JesseLevine727/AirNote/hardware/outputs/airnote-board.png

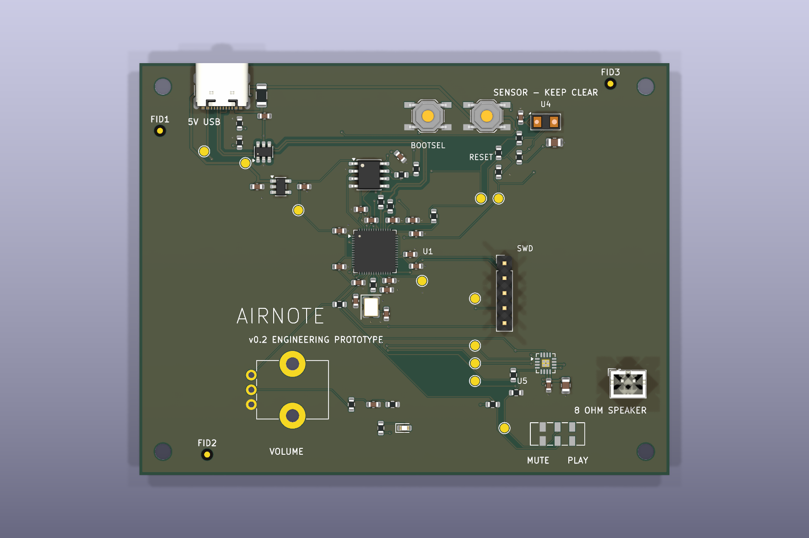
hardware/outputs/airnote-board.png
