JesseLevine727/AirNote/hardware/outputs/airnote-placement.png

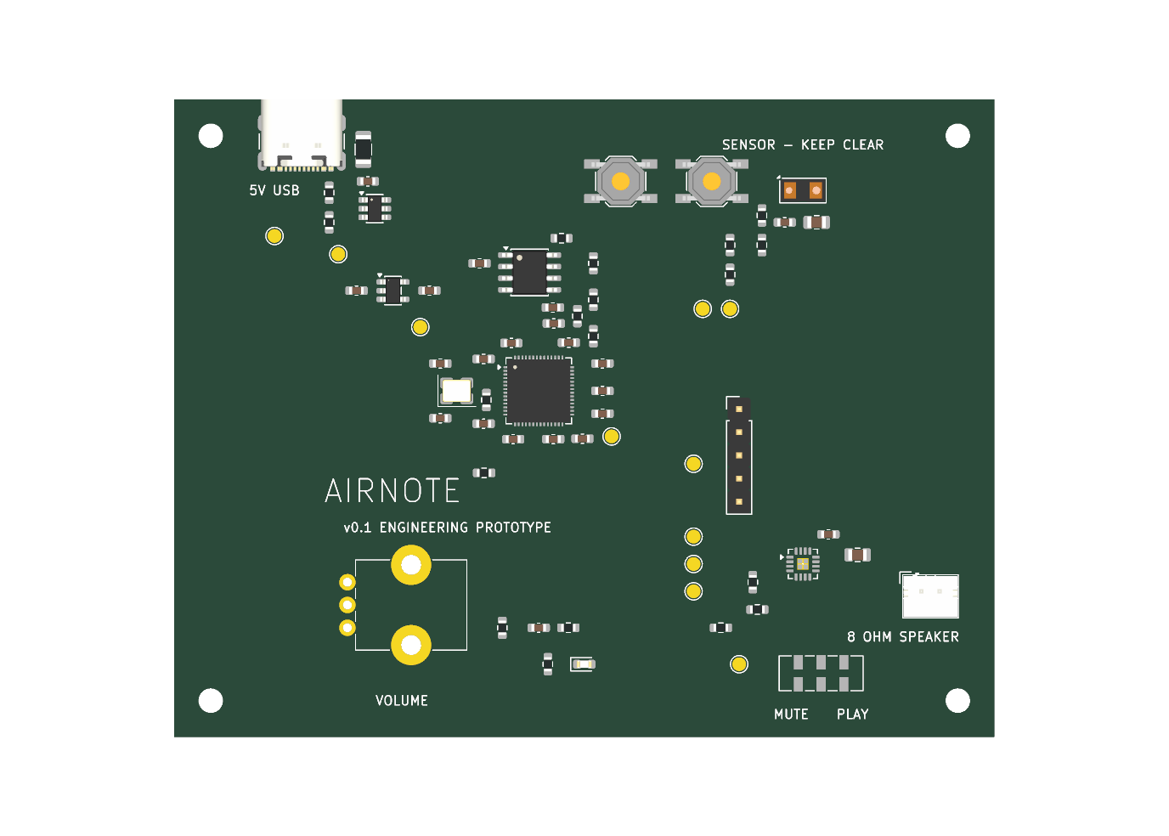
hardware/outputs/airnote-placement.png
