JesseLevine727/AirNote/hardware/reference/RPI-RP2040-MINIMAL_R3-S1_public/RPI-RP2040-MINIMAL_R3-S1_BOM.xlsx

Sheet: TOP
DOCUMENT IS AUTO-GENERATED, DO NOT HAND MODIFY
Variant Name | RPI-RP2040-MINIMAL | <-- Name of specific variant this BOM is for
Variant Description | RP2040 Minimal Design Example
PCB Revision | R3 | <-- PCB revision this BOM is for
Schematic/BOM Revision | S1 | <-- Schematic/BOM revision
Generation Date | 2026-07-08 13:39:50 UTC
Generation Format | 11

Sheet: BOM
Item | QTY | Refs | Value | Manufacturer | Manufacturer-PN | RPI-PDB-PN | Description
1 | 3 | C1,C4,C17 | 10u | Murata | GRM21BR61C106KE15L | RP-01GYSK-AVBE41 | Capacitor, MLCC, 10uF, 10%, M2012, 16V, X5R
2 | 2 | C2,C3 | 15p | Murata | GRM1555C1H150JA01D | RP-01C89W-LLY9XV | Capacitor, MLCC, 15pF, 5%, M1005, 50V, C0G
3 | 10 | C5,C6,C7,C9,C11,C12,C13,C14,C15,C16 | 100n | Murata | GRM155R71E104KE14D | RP-01BJ9Y-KRGF41 | Capacitor, MLCC, 100nF, 10%, M1005, 25V, X7R (10k Reel)
4 | 2 | C8,C10 | 1u | Murata | GRM155R61C105KA12D | RP-01GYSK-L7FEKV | Capacitor, MLCC, 1uF, 10%, M1005, 16V, X5R (10k Reel)
5 | 1 | J1 | 10103594-0001LF | Amphenol | 10103594-0001LF | RP-019A1P-1JAX7V | Micro-USB B, Socket, RA, PTH/SMT
6 | 1 | J2 | TSW-102-07-G-S | Samtec | TSW-102-07-G-S | RP-01JV5X-LY21H5 | Pin Header, 01x02W, 2.54mm, PTH, Male
7 | 2 | J3,J4 | TSW-118-07-L-D | Samtec | TSW-118-07-L-D | RP-01JWH2-G371Y4 | Pin Header, 02x18W, 2.54mm, PTH, Male
8 | 2 | R1,R5 | 1k | Yageo | RC0402FR-071KL | RP-019A1P-4Z6ZWY | Resistor, Chip, 1kR, M1005, 63mW, 1% (10k Reel)
9 | 1 | R2 | NO-FIT |  | NO-FIT
10 | 2 | R3,R4 | 27 | Yageo | RC0402FR-0727RL | RP-01C89V-LTEYC4 | Resistor, Chip, 27R, M1005, 63mW, 1% (10k Reel)
11 | 1 | U1 | NCP1117ST33T3G | ON Semiconductor | NCP1117ST33T3G | RP-01JWD9-7JRX6J | LDO, Vin=4.75-20V, Vout=3.3V, 1A min, SOT-223
12 | 1 | U2 | W25Q128JVSIQ | Winbond | W25Q128JVSIQ | RP-01JWD4-F1H4N9 | Serial NOR Flash, QSPI, 3V, 128Mbit, SOIC-8
13 | 1 | U3 | RP2040 | Raspberry Pi | RP2040 | RP-01EKHS-ZTKTEH | RP2040 MCU, Dual Cortex M0+, QFN-56
14 | 1 | X1 | 12MHz | Abracon | ABM8-272-T3 | RP-01G8X7-GS352B | XTAL, SMT, 12 MHz, Fundamental, Ftol=30ppm, Fstab=30ppm, 10pF, 3.2x2.5mm
15 | XXX | PCB | R3 | XXX | XXX |  | XXX
