JesseLevine727/AirNote/hardware/outputs/airnote-schematic.pdf

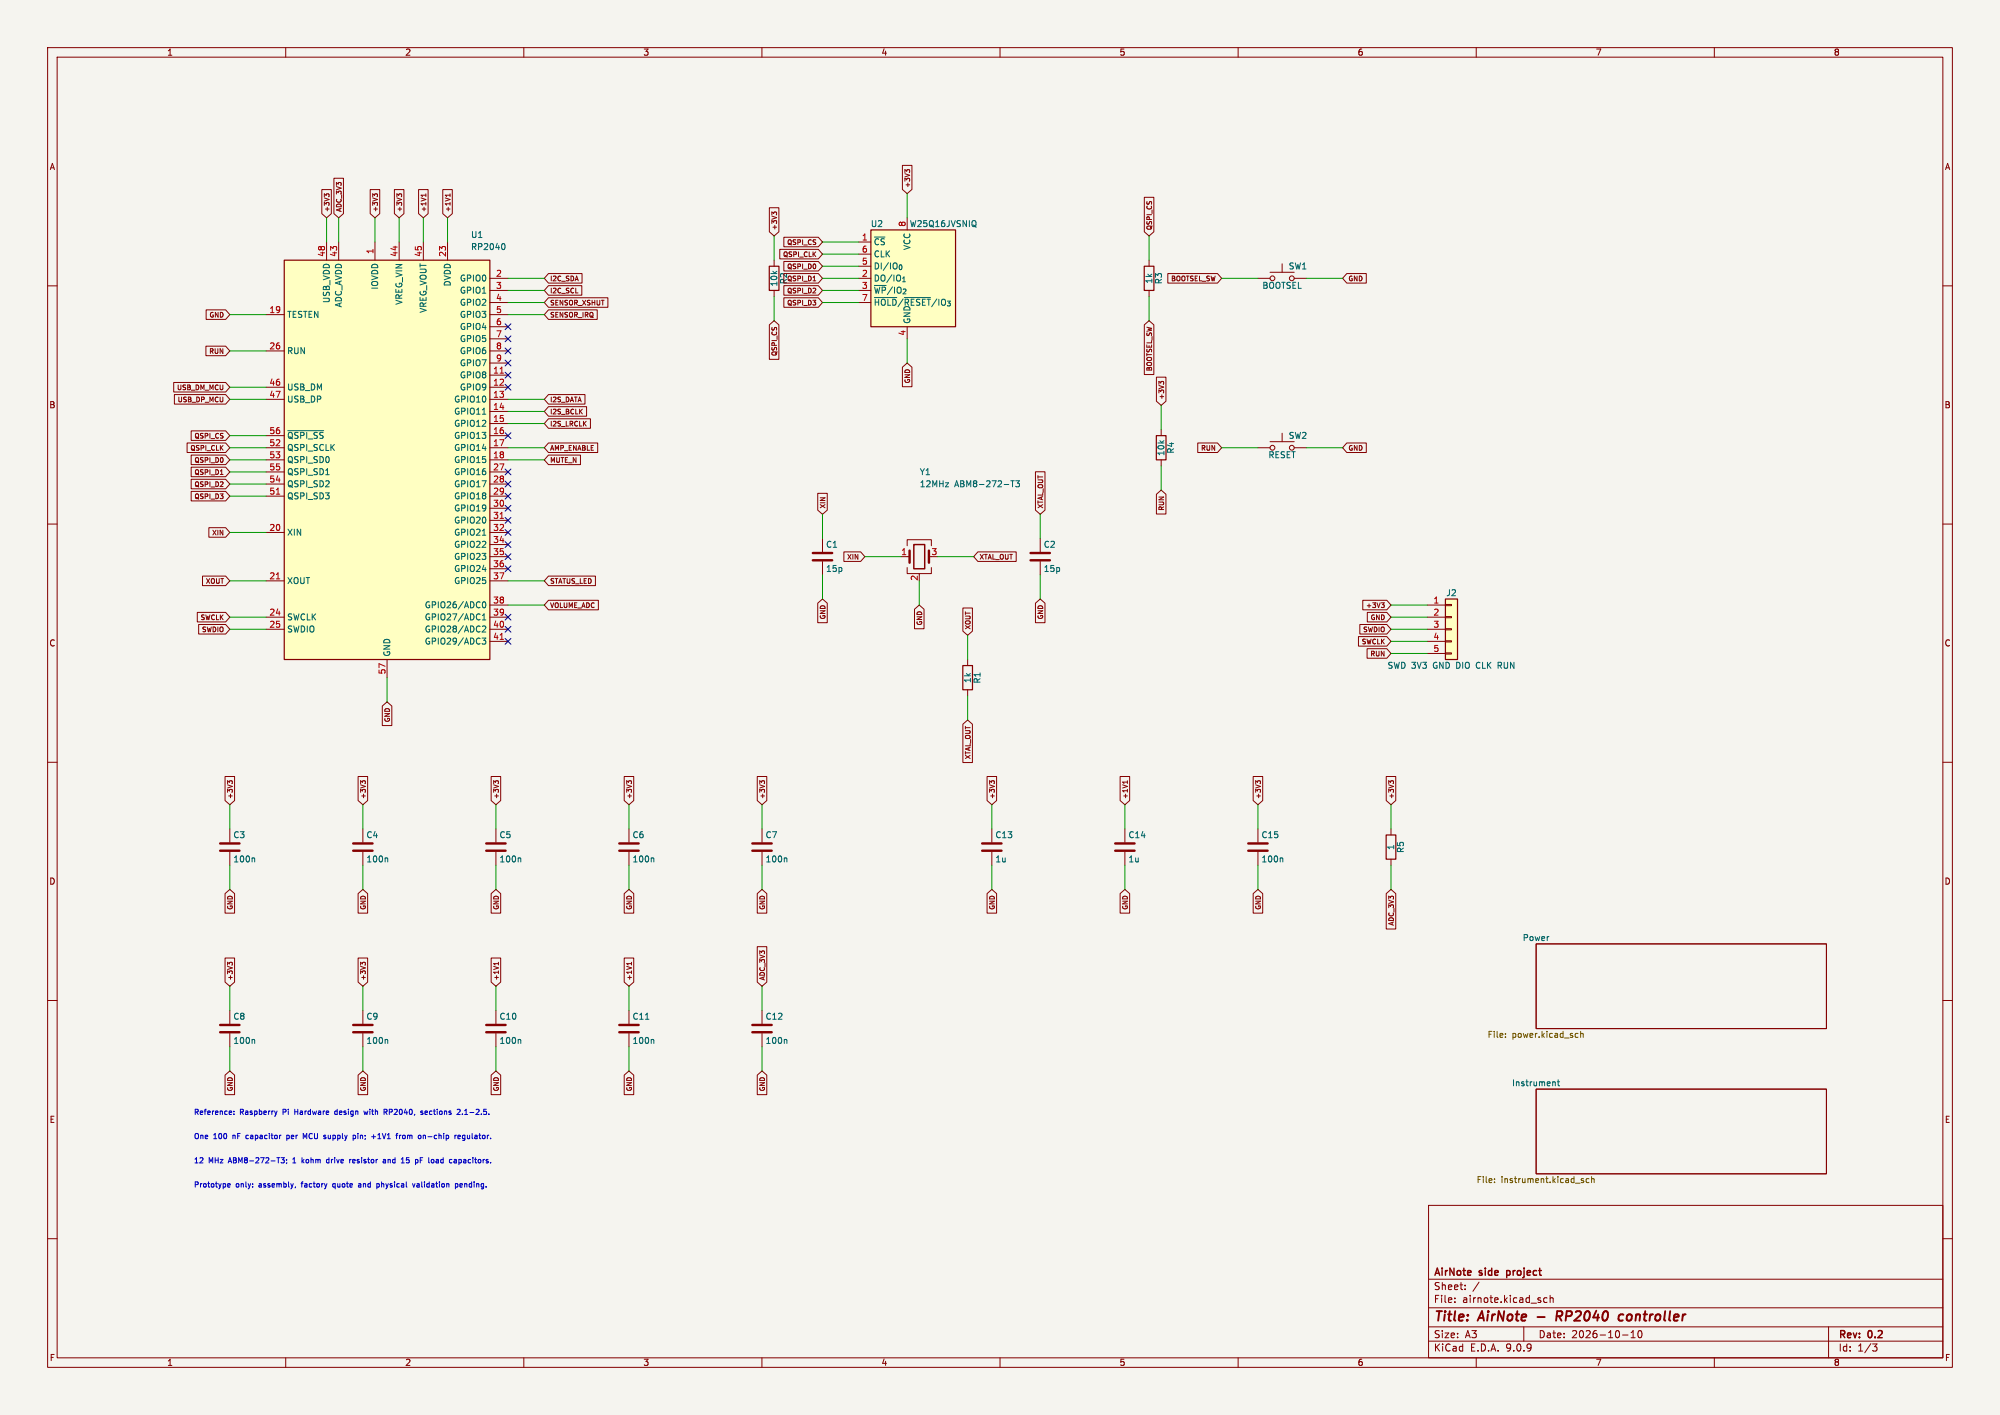
[picture p3: page 1]

Instrument File: instrument.kicad_sch Power File: power.kicad_sch 1kR3

J2 SWD 3V3 GND DIO CLK RUN

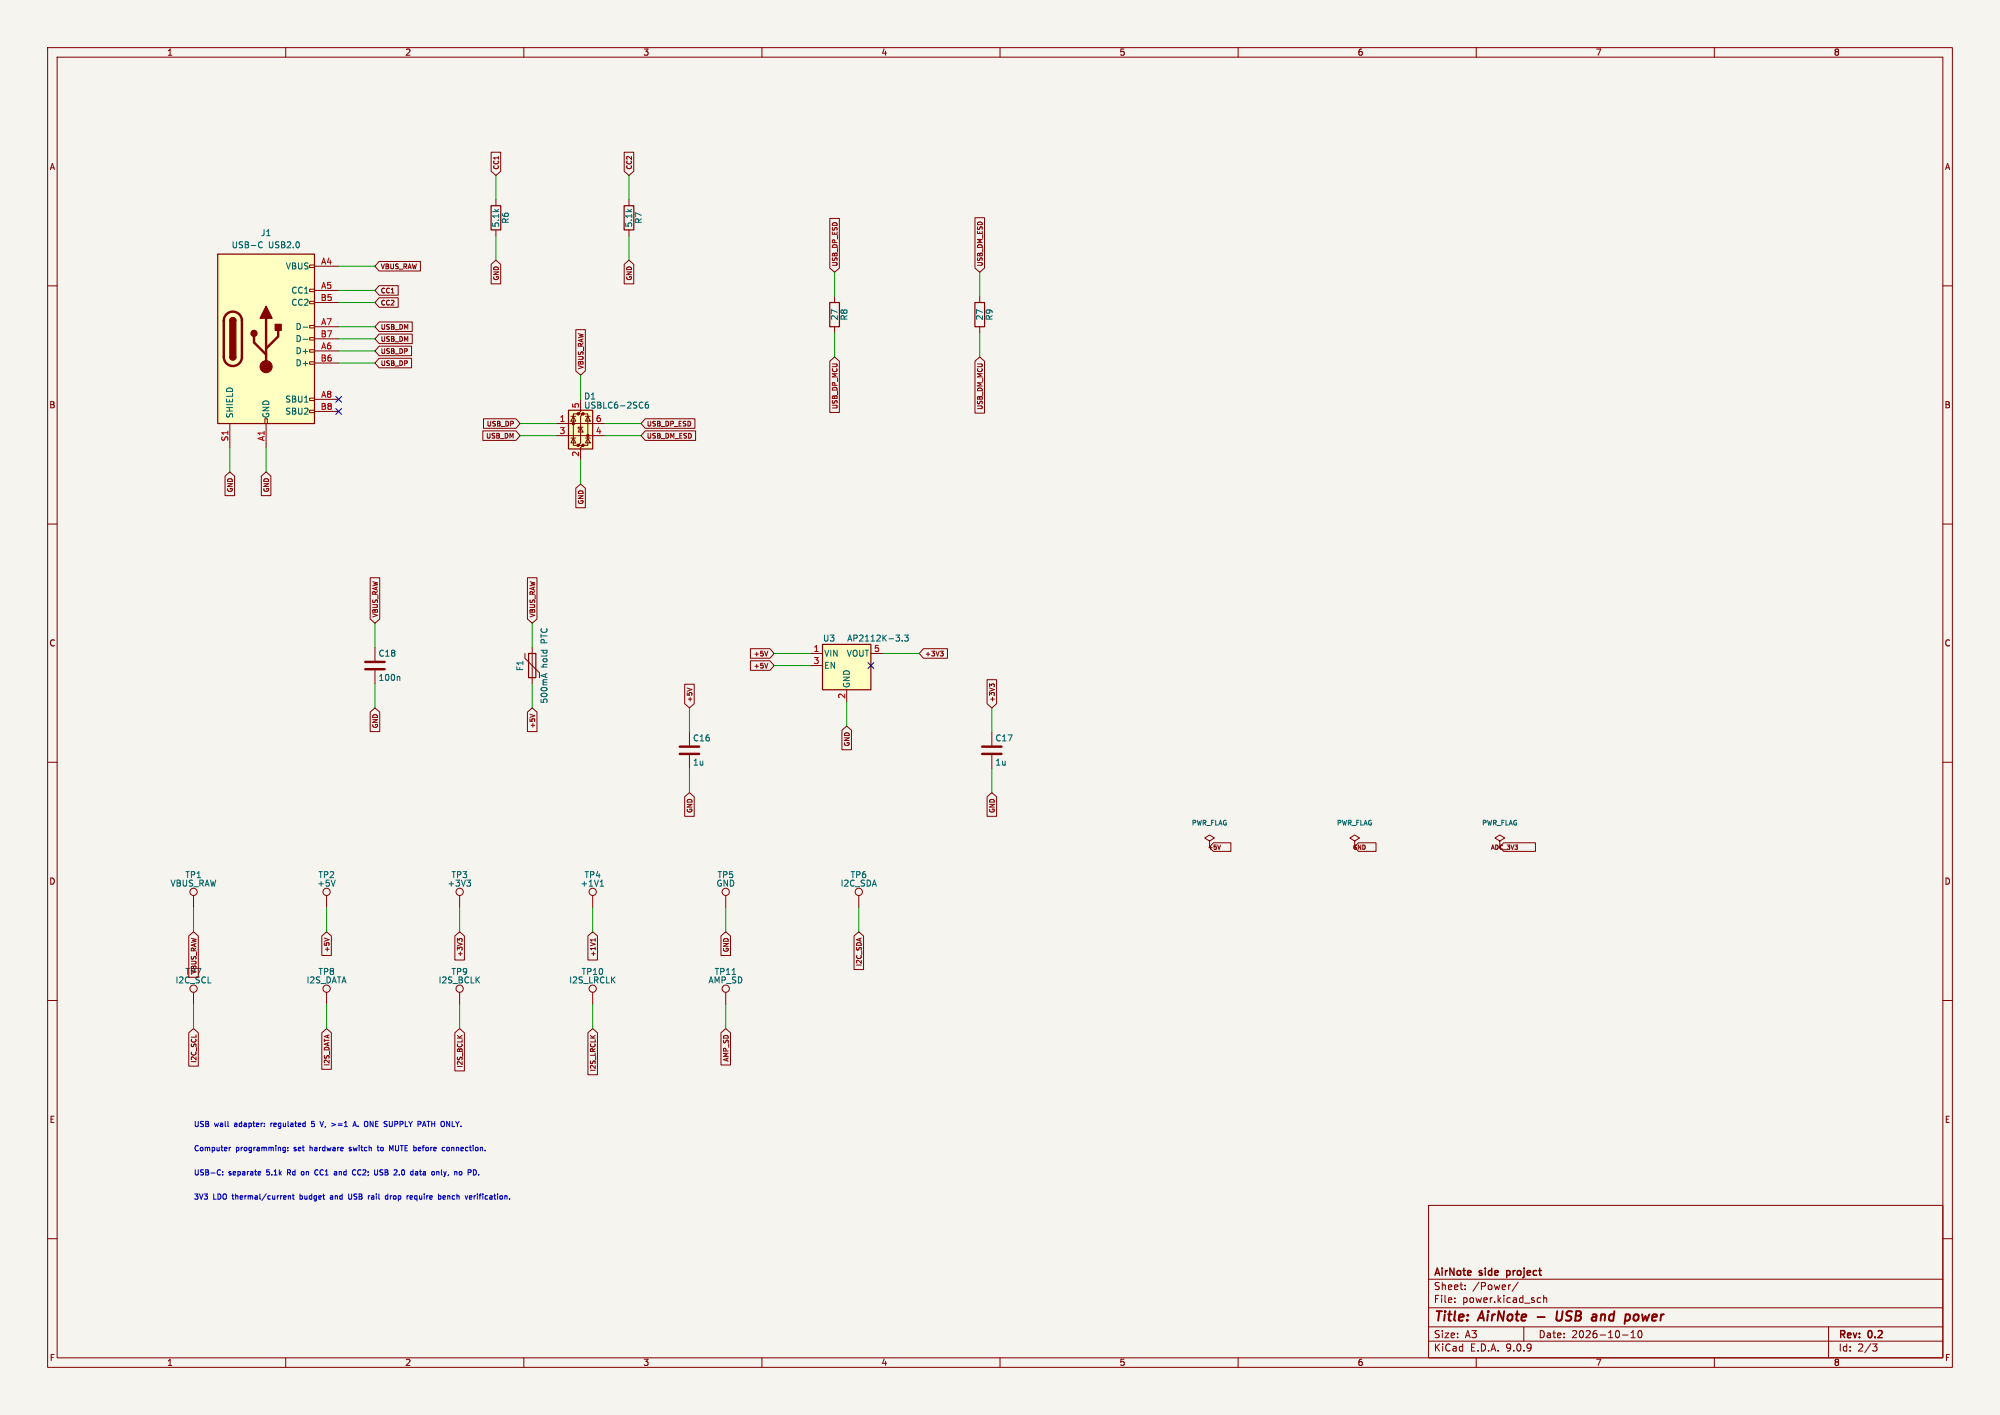
[picture p4: page 2]

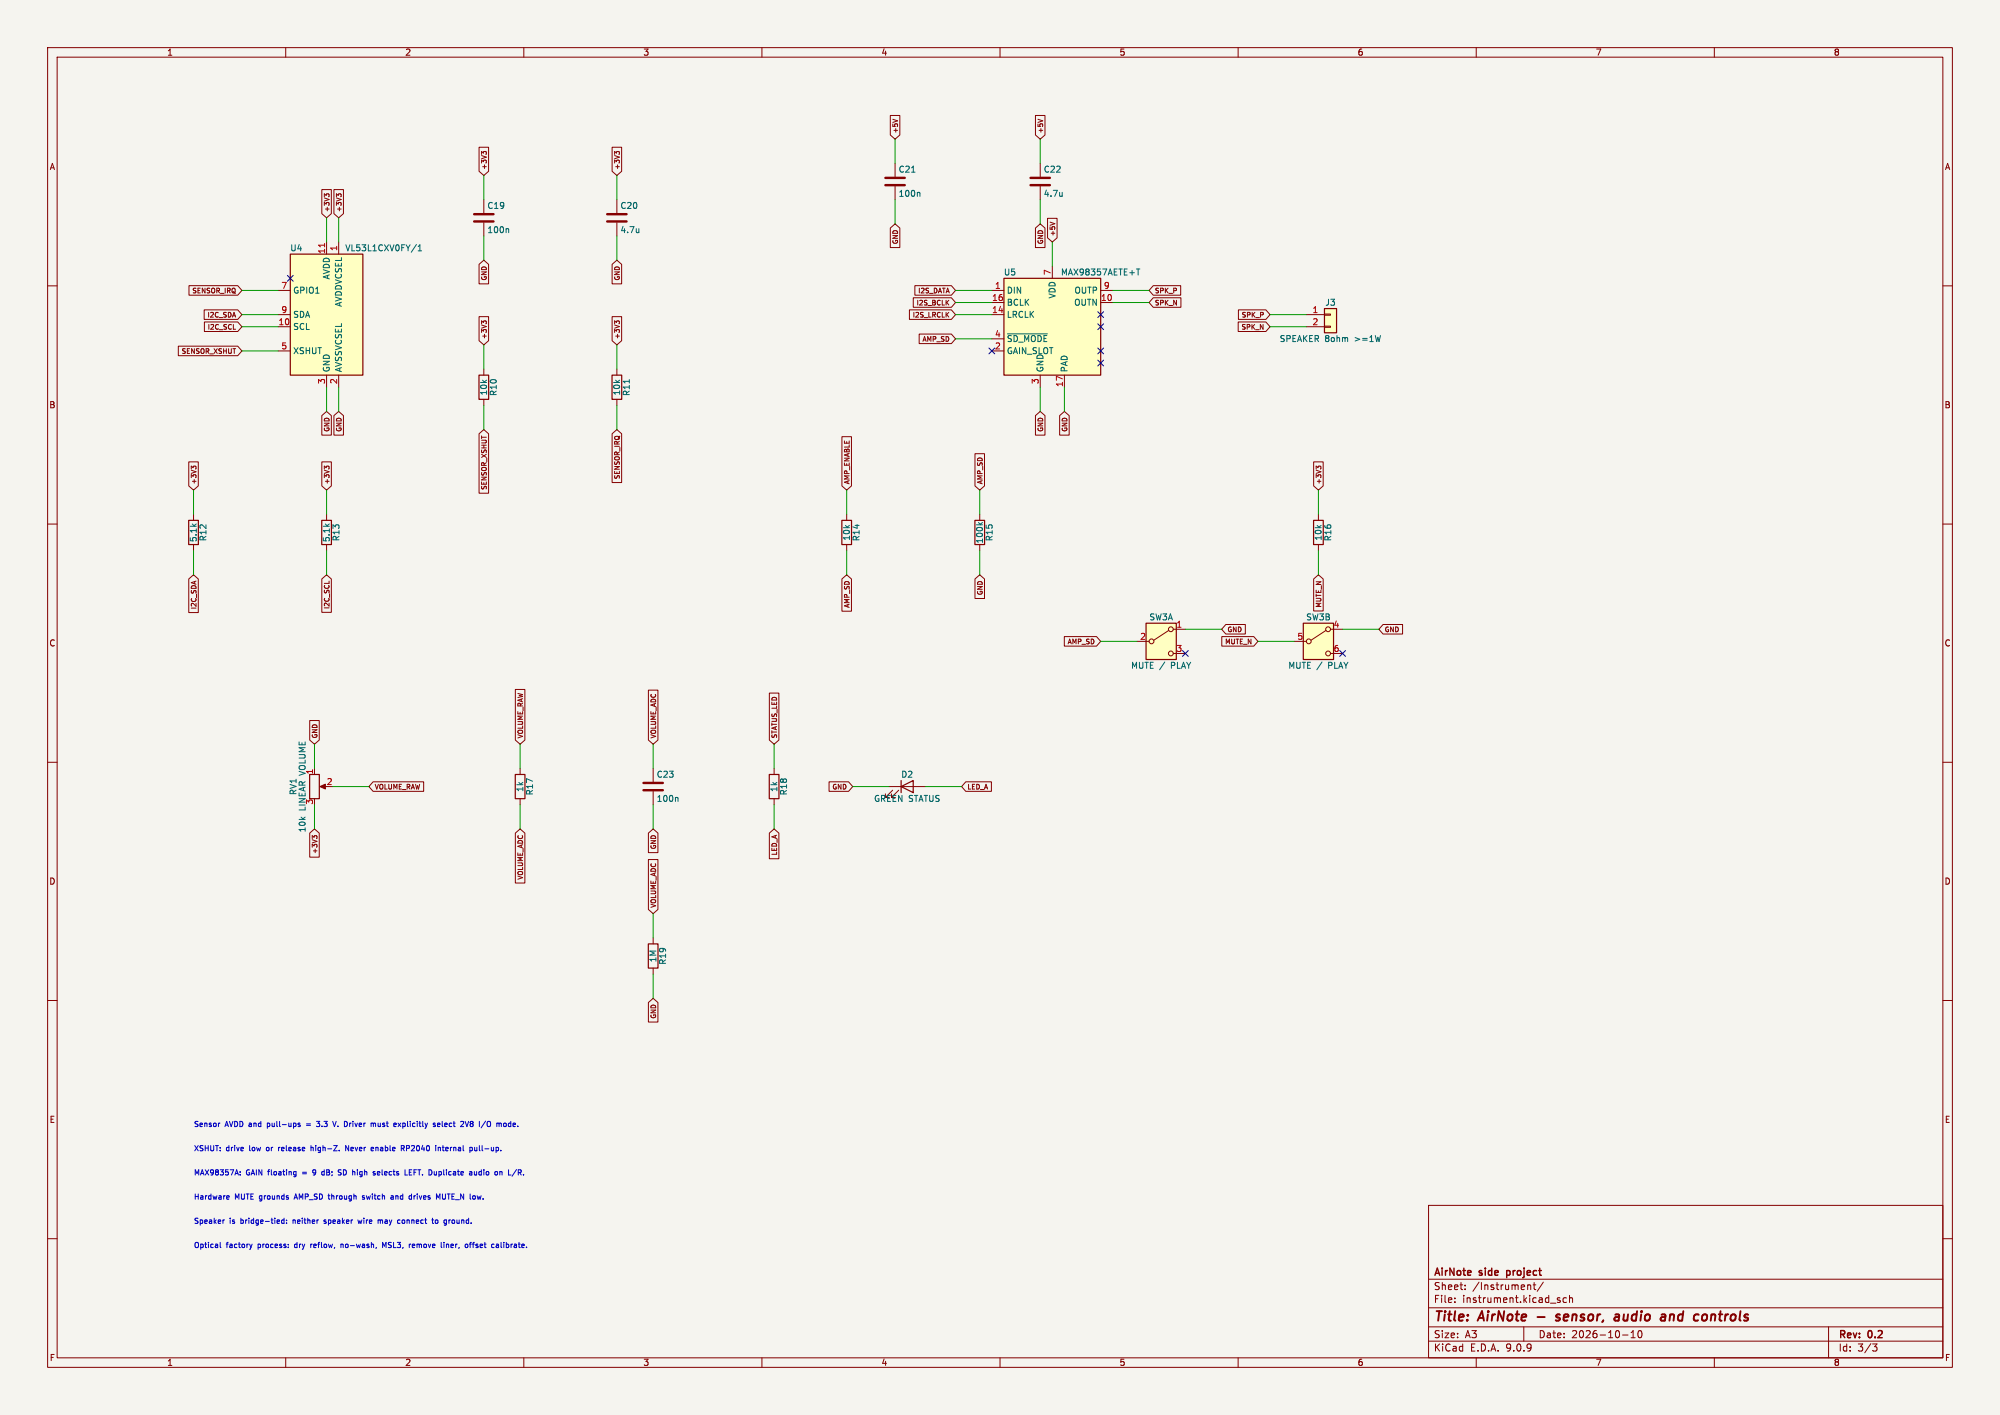
[picture p5: page 3]

Id: 3/3 Title: AirNote - sensor, audio and controls
