JesseLevine727/AirNote/hardware/outputs/airnote-assembly.pdf

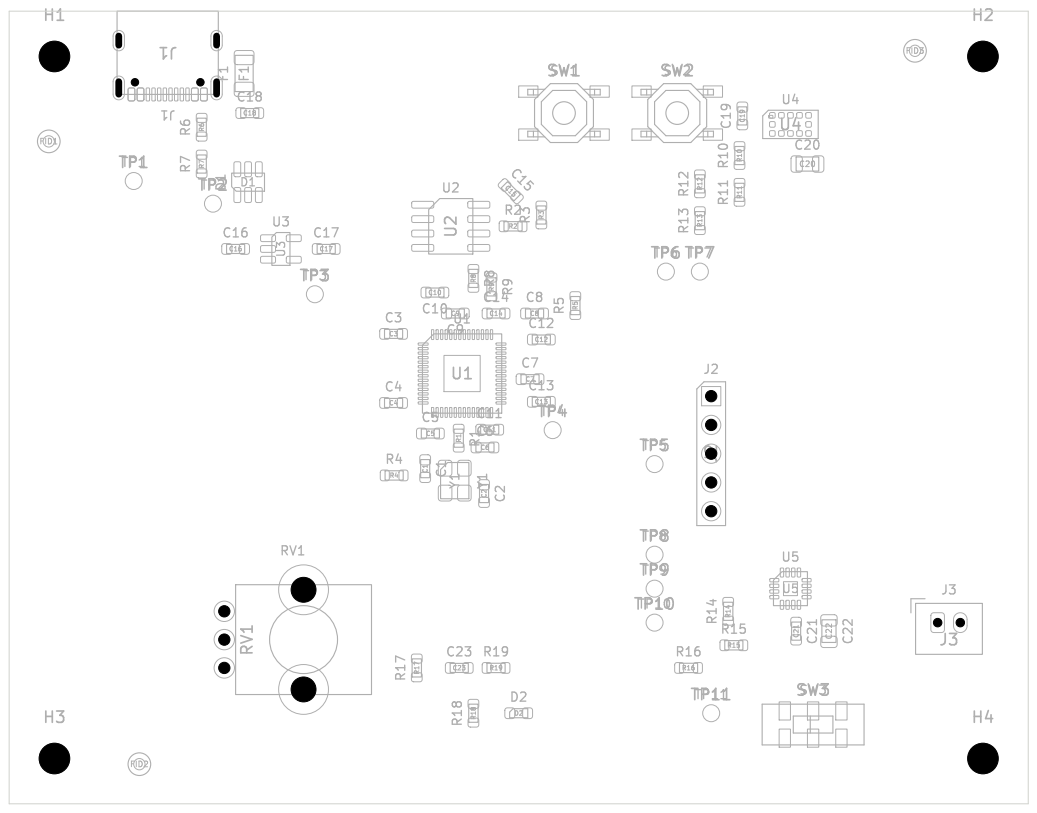
[picture p6: page 1]
