JesseLevine727/AirNote/(list of files, drawings)

Other design files:
hardware/outputs/airnote-route-local.dsn
hardware/outputs/airnote-route.dsn
hardware/outputs/airnote-unrouted.dsn
