JesseLevine727/AirNote/hardware/airnote.kicad_pcb

## KiCad design hardware/airnote.kicad_pcb (2026-10-10)

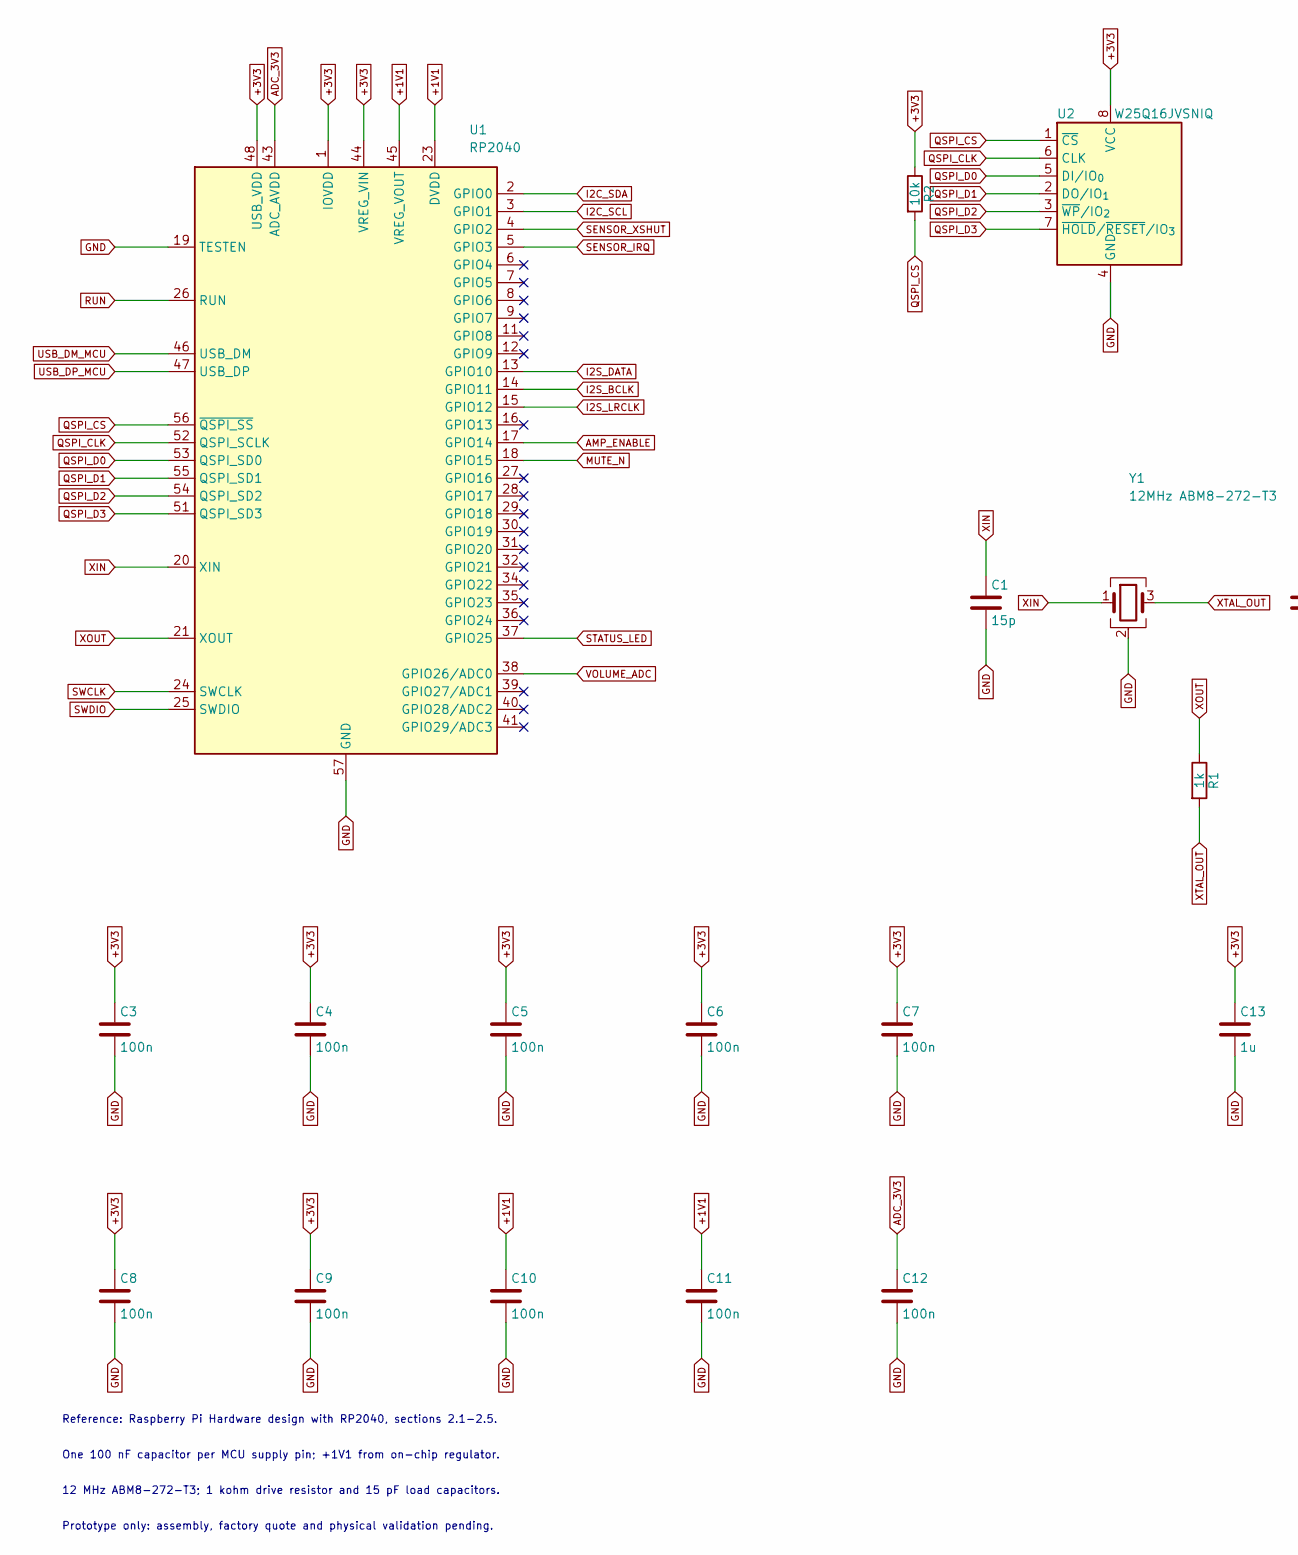
[picture p11: schematic airnote.kicad_sch, AirNote - RP2040 controller, part in row 1, column 1]

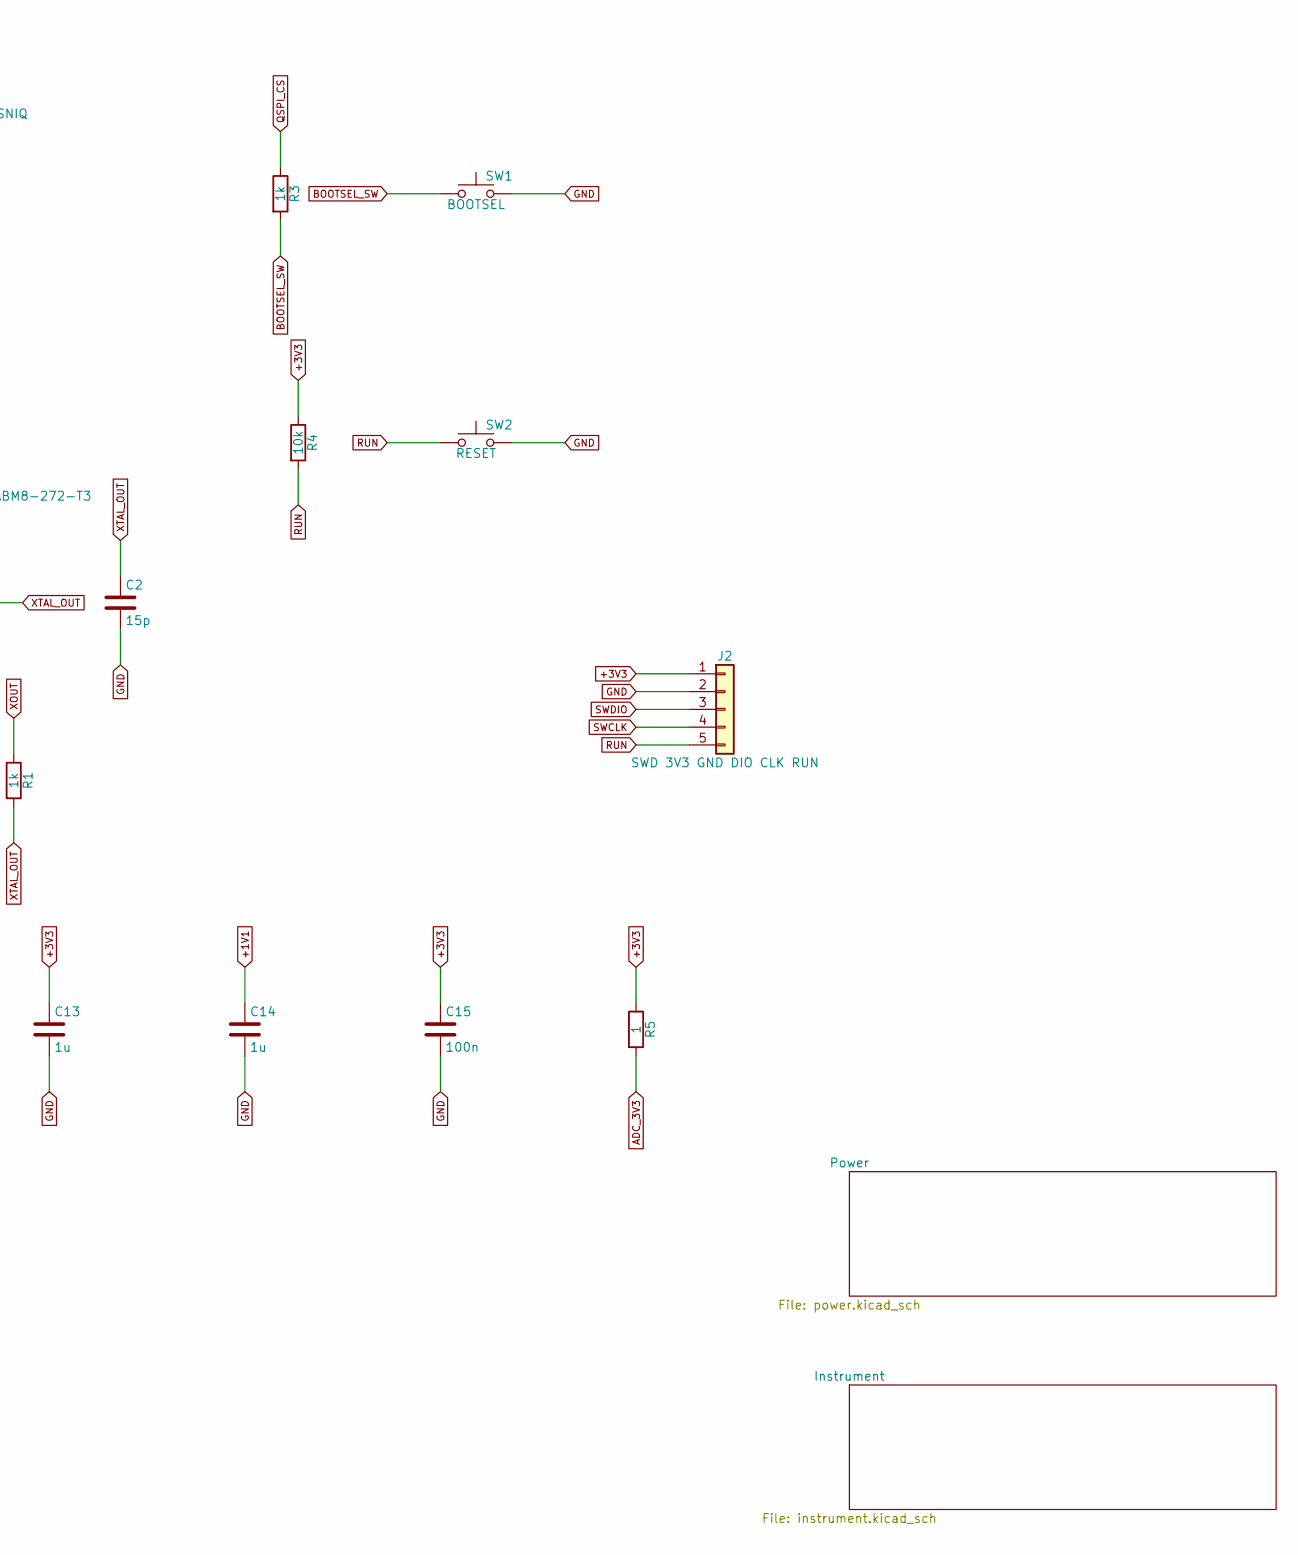
[picture p12: schematic airnote.kicad_sch, AirNote - RP2040 controller, part in row 1, column 2]

Parts:
C1, C2: 15p; C_0603_1608Metric; MPN CL10C150JB8NNNC; LCSC C1644
C3, C4, C5, C6, C7, C8, C9, C10, C11, C12, C15: 100n; C_0603_1608Metric; MPN CC0603KRX7R9BB104; LCSC C14663
C13, C14: 1u; C_0603_1608Metric; MPN CL10A105KB8NNNC; LCSC C15849
J2: SWD 3V3 GND DIO CLK RUN; PinHeader_1x05_P2.54mm_Vertical; MPN HX PZ2.54-1x5P ZZ; LCSC C32713271
R1, R3: 1k; R_0603_1608Metric; MPN 0603WAF1001T5E; LCSC C21190
R2, R4: 10k; R_0603_1608Metric; MPN 0603WAF1002T5E; LCSC C25804
R5: 1; R_0603_1608Metric; MPN 0603WAF100KT5E; LCSC C22936
SW1: BOOTSEL; SW_SPST_TL3342; MPN TL3342F160QG; LCSC C2886898
SW2: RESET; SW_SPST_TL3342; MPN TL3342F160QG; LCSC C2886898
U1: RP2040; QFN-56-1EP_7x7mm_P0.4mm_EP3.2x3.2mm; MPN RP2040; LCSC C2040
U2: W25Q16JVSNIQ; SOIC-8_3.9x4.9mm_P1.27mm; MPN W25Q16JVSNIQ; LCSC C2456211
Y1: 12MHz ABM8-272-T3; Crystal_SMD_3225-4Pin_3.2x2.5mm; MPN ABM8-272-T3; LCSC C20625731

Connections:
+1V1: C10.1, C11.1, C14.1, U1.23 (DVDD), U1.45 (VREG_VOUT), U1.50 (DVDD); also elsewhere on the board
+3V3: C3.1, C4.1, C5.1, C6.1, C7.1, C8.1, C9.1, C13.1, C15.1, J2.1, R2.1, R4.1, R5.1, U1.1 (IOVDD), U1.10 (IOVDD), U1.22 (IOVDD), U1.33 (IOVDD), U1.42 (IOVDD), U1.44 (VREG_VIN), U1.48 (USB_VDD), U1.49 (IOVDD), U2.8 (VCC); also elsewhere on the board
ADC_3V3: C12.1, R5.2, U1.43 (ADC_AVDD)
AMP_ENABLE: U1.17 (GPIO14); also elsewhere on the board
BOOTSEL_SW: R3.2, SW1.1
GND: C1.2, C2.2, C3.2, C4.2, C5.2, C6.2, C7.2, C8.2, C9.2, C10.2, C11.2, C12.2, C13.2, C14.2, C15.2, J2.2, SW1.2, SW2.2, U1.19 (TESTEN), U1.57 (GND), U2.4 (GND), Y1.2 (G), Y1.4 (G); also elsewhere on the board
I2C_SCL: U1.3 (GPIO1); also elsewhere on the board
I2C_SDA: U1.2 (GPIO0); also elsewhere on the board
I2S_BCLK: U1.14 (GPIO11); also elsewhere on the board
I2S_DATA: U1.13 (GPIO10); also elsewhere on the board
I2S_LRCLK: U1.15 (GPIO12); also elsewhere on the board
MUTE_N: U1.18 (GPIO15); also elsewhere on the board
QSPI_CLK: U1.52 (QSPI_SCLK), U2.6 (CLK)
QSPI_CS: R2.2, R3.1, U1.56 (~QSPI_SS), U2.1 (~CS)
QSPI_D0: U1.53 (QSPI_SD0), U2.5 (DI/IO_{0})
QSPI_D1: U1.55 (QSPI_SD1), U2.2 (DO/IO_{1})
QSPI_D2: U1.54 (QSPI_SD2), U2.3 (~WP/IO_{2})
QSPI_D3: U1.51 (QSPI_SD3), U2.7 (~HOLD/~RESET/IO_{3})
RUN: J2.5, R4.2, SW2.1, U1.26 (RUN)
SENSOR_IRQ: U1.5 (GPIO3); also elsewhere on the board
SENSOR_XSHUT: U1.4 (GPIO2); also elsewhere on the board
STATUS_LED: U1.37 (GPIO25); also elsewhere on the board
SWCLK: J2.4, U1.24 (SWCLK)
SWDIO: J2.3, U1.25 (SWDIO)
USB_DM_MCU: U1.46 (USB_DM); also elsewhere on the board
USB_DP_MCU: U1.47 (USB_DP); also elsewhere on the board
VOLUME_ADC: U1.38 (GPIO26/ADC0); also elsewhere on the board
XIN: C1.1, U1.20 (XIN), Y1.1
XOUT: R1.1, U1.21 (XOUT)
XTAL_OUT: C2.1, R1.2, Y1.3

Notes on the sheet:
Reference: Raspberry Pi Hardware design with RP2040, sections 2.1-2.5.
One 100 nF capacitor per MCU supply pin; +1V1 from on-chip regulator.
12 MHz ABM8-272-T3; 1 kohm drive resistor and 15 pF load capacitors.
Prototype only: assembly, factory quote and physical validation pending.

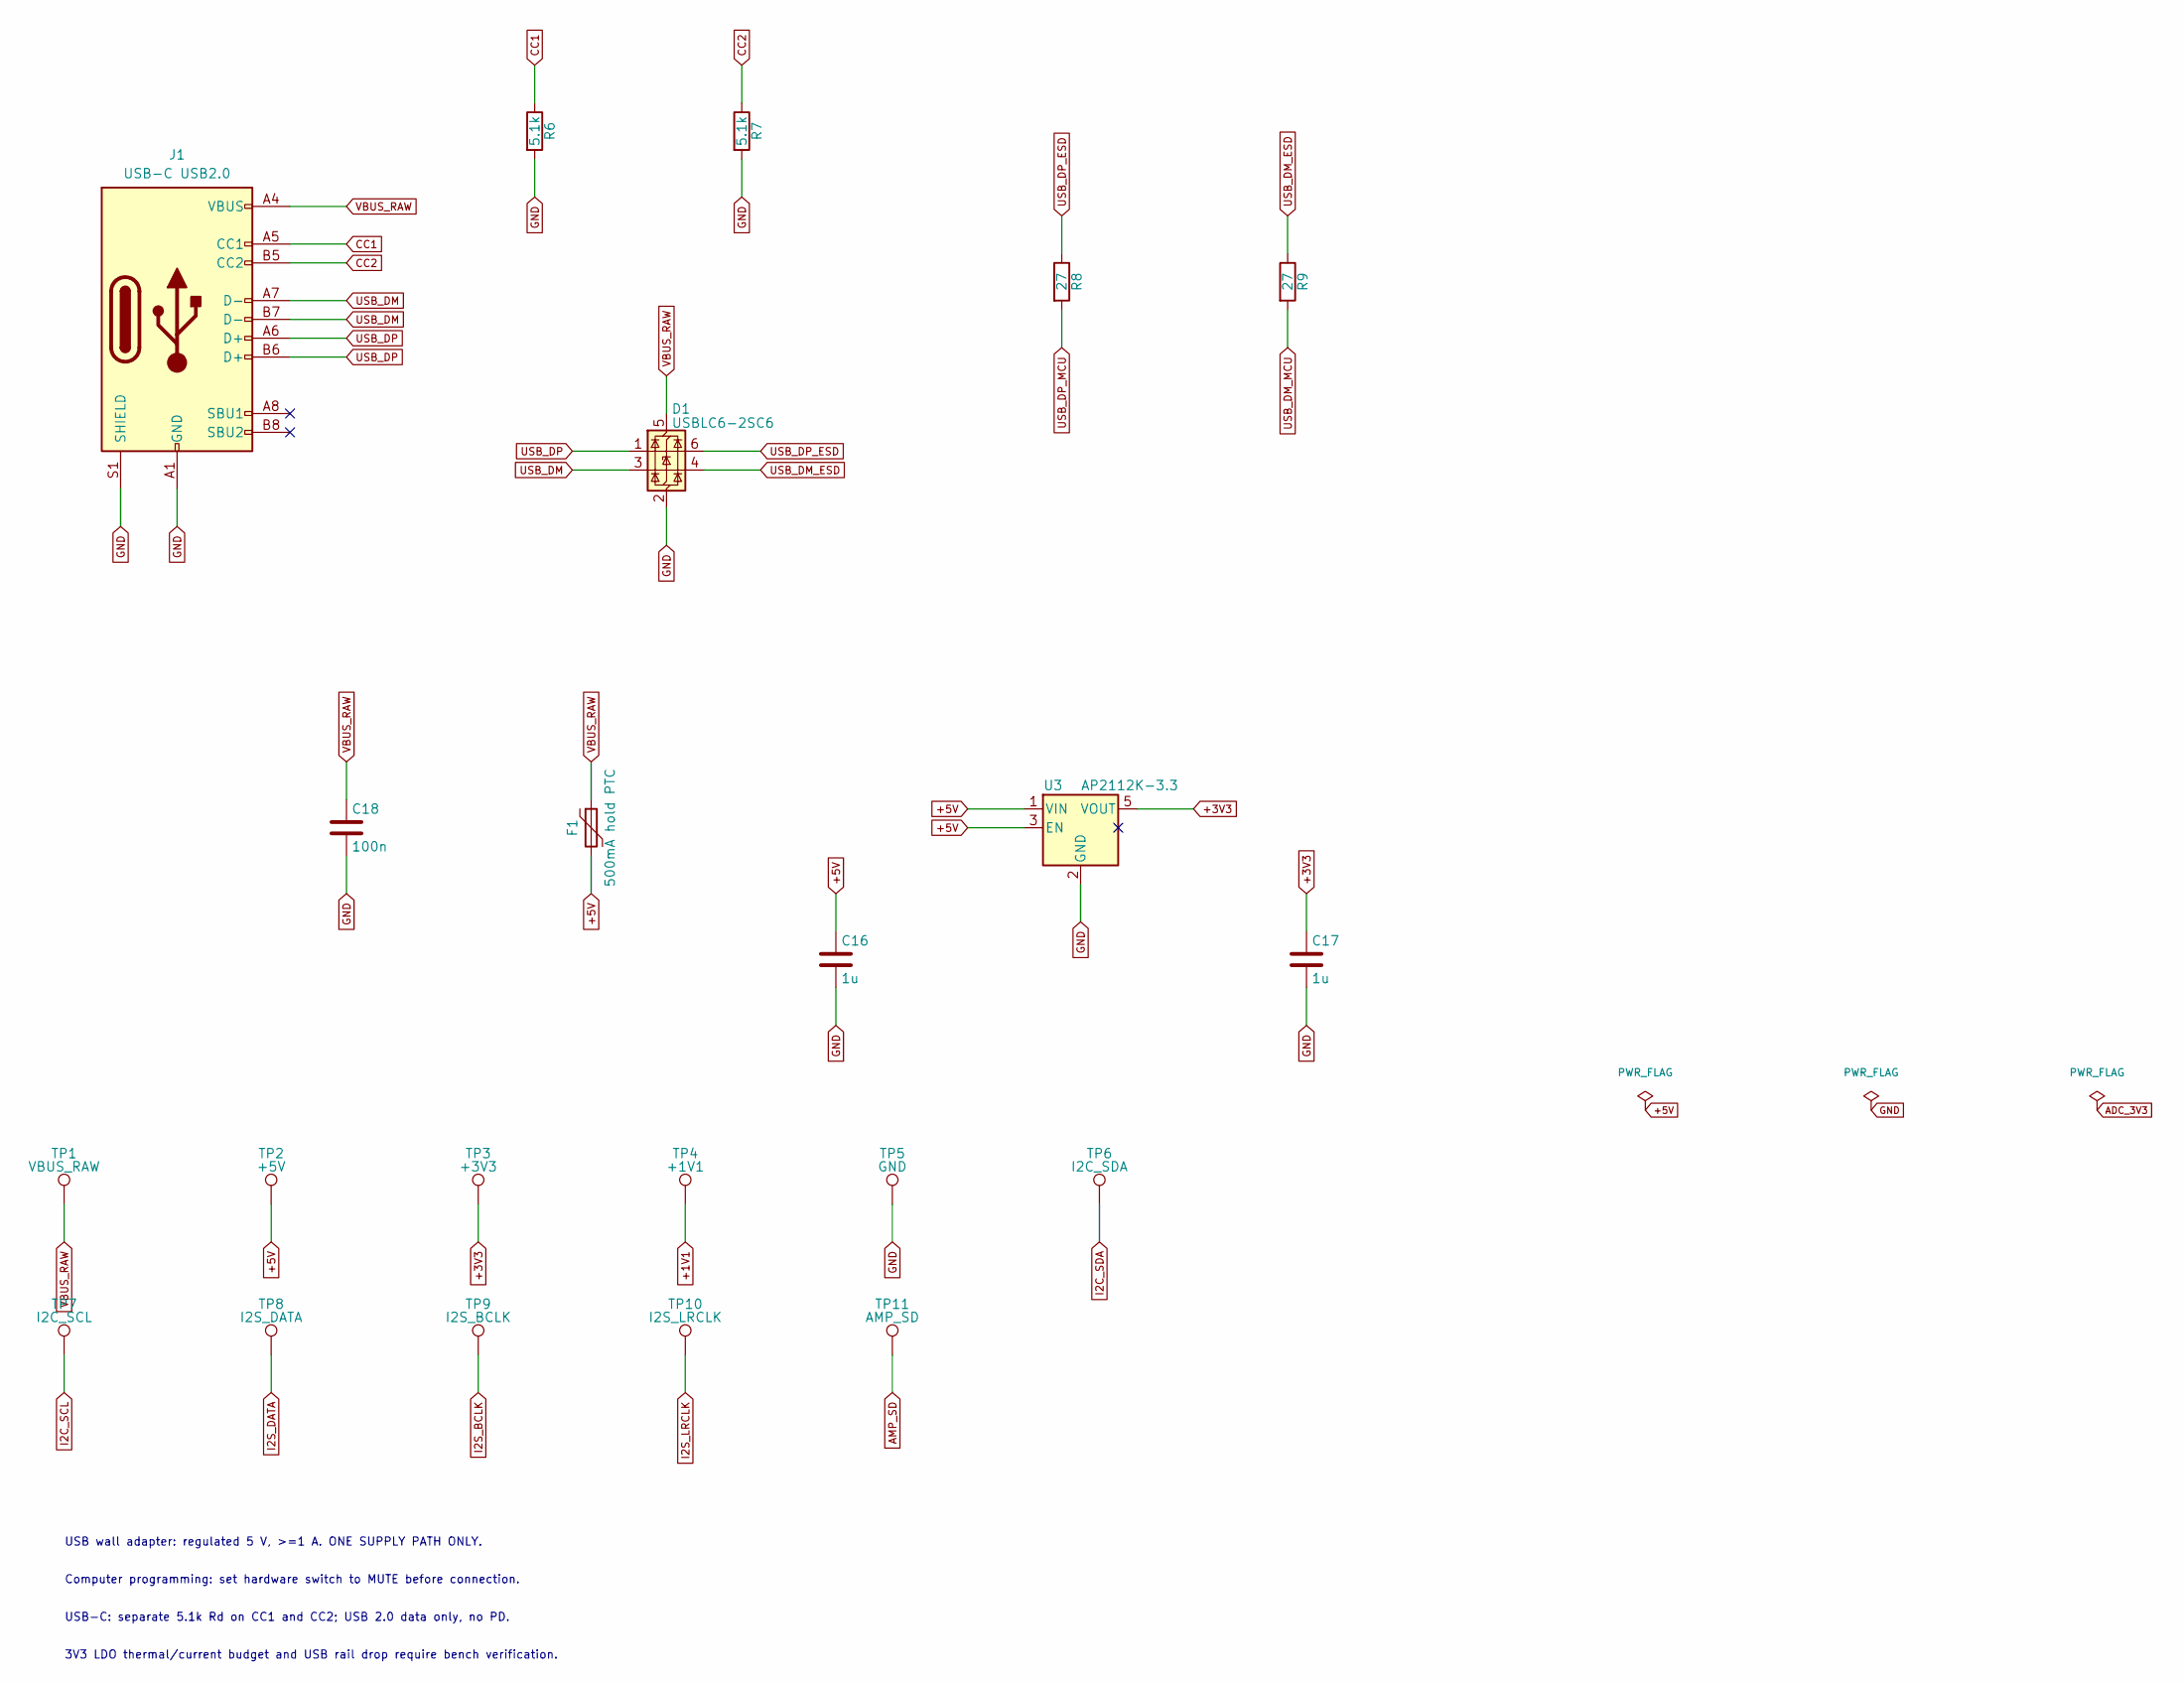
[picture p13: schematic power.kicad_sch, AirNote - USB and power]

Parts:
C16, C17: 1u; C_0603_1608Metric; MPN CL10A105KB8NNNC; LCSC C15849
C18: 100n; C_0603_1608Metric; MPN CC0603KRX7R9BB104; LCSC C14663
D1: USBLC6-2SC6; SOT-23-6; MPN USBLC6-2SC6; LCSC C7519
F1: 500mA hold PTC; Fuse_1206_3216Metric; MPN 1206L050YR; LCSC C163512
J1: USB-C USB2.0; USB_C_Receptacle_GCT_USB4105-xx-A_16P_TopMnt_Horizontal; MPN USB4105-GF-A-120; LCSC C5184243
R6, R7: 5.1k; R_0603_1608Metric; MPN 0603WAF5101T5E; LCSC C23186
R8, R9: 27; R_0603_1608Metric; MPN 0603WAF270JT5E; LCSC C25190
TP1: VBUS_RAW; TestPoint_Pad_D1.5mm; MPN TEST_PAD_1.5MM
TP2: +5V; TestPoint_Pad_D1.5mm; MPN TEST_PAD_1.5MM
TP3: +3V3; TestPoint_Pad_D1.5mm; MPN TEST_PAD_1.5MM
TP4: +1V1; TestPoint_Pad_D1.5mm; MPN TEST_PAD_1.5MM
TP5: GND; TestPoint_Pad_D1.5mm; MPN TEST_PAD_1.5MM
TP6: I2C_SDA; TestPoint_Pad_D1.5mm; MPN TEST_PAD_1.5MM
TP7: I2C_SCL; TestPoint_Pad_D1.5mm; MPN TEST_PAD_1.5MM
TP8: I2S_DATA; TestPoint_Pad_D1.5mm; MPN TEST_PAD_1.5MM
TP9: I2S_BCLK; TestPoint_Pad_D1.5mm; MPN TEST_PAD_1.5MM
TP10: I2S_LRCLK; TestPoint_Pad_D1.5mm; MPN TEST_PAD_1.5MM
TP11: AMP_SD; TestPoint_Pad_D1.5mm; MPN TEST_PAD_1.5MM
U3: AP2112K-3.3; SOT-23-5; MPN AP2112K-3.3TRG1; LCSC C51118

Connections:
+1V1: TP4.1; also elsewhere on the board
+3V3: C17.1, TP3.1, U3.5 (VOUT); also elsewhere on the board
+5V: C16.1, F1.2, TP2.1, U3.1 (VIN), U3.3 (EN); also elsewhere on the board
AMP_SD: TP11.1; also elsewhere on the board
CC1: J1.A5 (CC1), R6.1
CC2: J1.B5 (CC2), R7.1
GND: C16.2, C17.2, C18.2, D1.2 (GND), J1.A1 (GND), J1.A12 (GND), J1.B1 (GND), J1.B12 (GND), J1.S1 (SHIELD), R6.2, R7.2, TP5.1, U3.2 (GND); also elsewhere on the board
I2C_SCL: TP7.1; also elsewhere on the board
I2C_SDA: TP6.1; also elsewhere on the board
I2S_BCLK: TP9.1; also elsewhere on the board
I2S_DATA: TP8.1; also elsewhere on the board
I2S_LRCLK: TP10.1; also elsewhere on the board
USB_DM: D1.3 (I/O2), J1.A7 (D-), J1.B7 (D-)
USB_DM_ESD: D1.4 (I/O2), R9.1
USB_DM_MCU: R9.2; also elsewhere on the board
USB_DP: D1.1 (I/O1), J1.A6 (D+), J1.B6 (D+)
USB_DP_ESD: D1.6 (I/O1), R8.1
USB_DP_MCU: R8.2; also elsewhere on the board
VBUS_RAW: C18.1, D1.5 (VBUS), F1.1, J1.A4 (VBUS), J1.A9 (VBUS), J1.B4 (VBUS), J1.B9 (VBUS), TP1.1

Notes on the sheet:
USB wall adapter: regulated 5 V, >=1 A. ONE SUPPLY PATH ONLY.
Computer programming: set hardware switch to MUTE before connection.
USB-C: separate 5.1k Rd on CC1 and CC2; USB 2.0 data only, no PD.
3V3 LDO thermal/current budget and USB rail drop require bench verification.

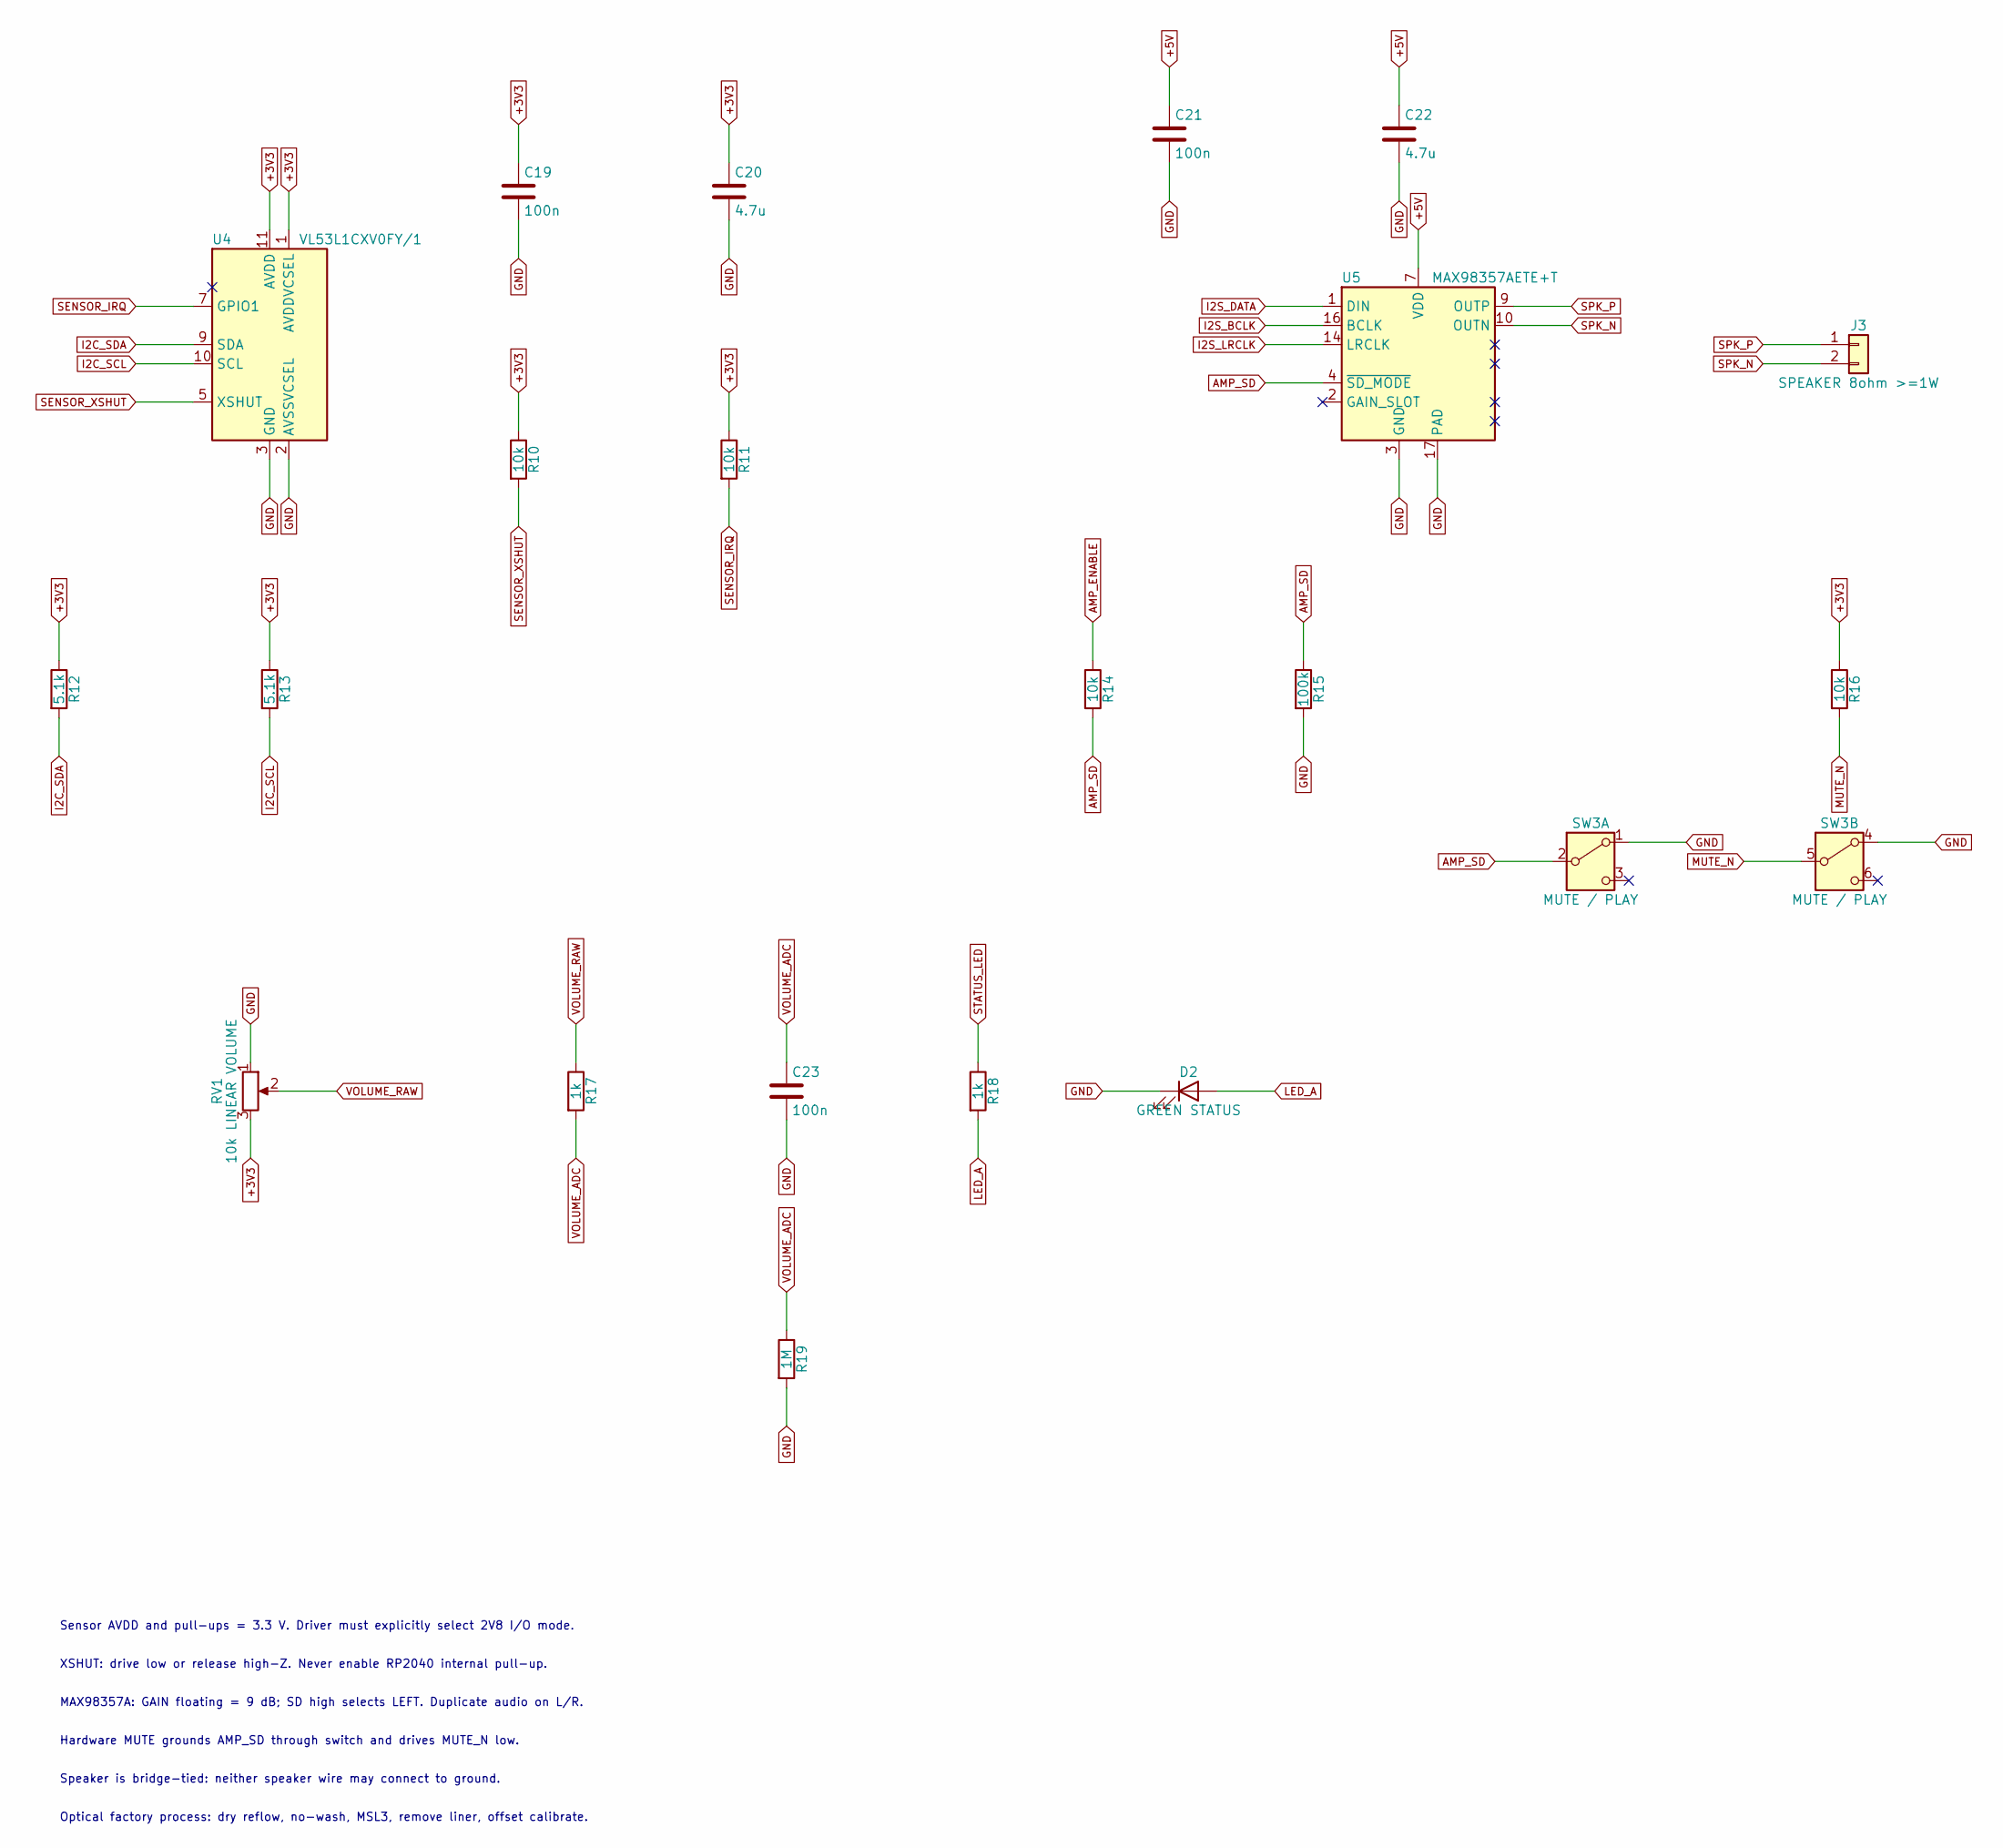
[picture p14: schematic instrument.kicad_sch, AirNote - sensor, audio and controls]

Parts:
C19, C21, C23: 100n; C_0603_1608Metric; MPN CC0603KRX7R9BB104; LCSC C14663
C20, C22: 4.7u; C_0805_2012Metric; MPN CL21A475KAQNNNE; LCSC C1779
D2: GREEN STATUS; LED_0603_1608Metric; MPN LTST-C190KGKT; LCSC C125094
J3: SPEAKER 8ohm >=1W; JST_PH_B2B-PH-K_1x02_P2.00mm_Vertical; MPN B2B-PH-K-S(LF)(SN); LCSC C131337
R10, R11, R14, R16: 10k; R_0603_1608Metric; MPN 0603WAF1002T5E; LCSC C25804
R12, R13: 5.1k; R_0603_1608Metric; MPN 0603WAF5101T5E; LCSC C23186
R15: 100k; R_0603_1608Metric; MPN 0603WAF1003T5E; LCSC C25803
R17, R18: 1k; R_0603_1608Metric; MPN 0603WAF1001T5E; LCSC C21190
R19: 1M; R_0603_1608Metric; MPN 0603WAF1004T5E; LCSC C22935
RV1: 10k LINEAR VOLUME; Potentiometer_Bourns_PTV09A-1_Single_Vertical; MPN PTV09A-4015F-B103; LCSC C5710902
SW3: MUTE / PLAY; SW_DPDT_CK_JS202011JCQN; MPN JS202011JCQN; LCSC C221665
U4: VL53L1CXV0FY/1; ST_VL53L1x; MPN VL53L1CXV0FY/1; LCSC C190004
U5: MAX98357AETE+T; MAX98357A_T1633_ADI_90-0031; MPN MAX98357AETE+T; LCSC C910544

Connections:
+3V3: C19.1, C20.1, R10.1, R11.1, R12.1, R13.1, R16.1, RV1.3, U4.1 (AVDDVCSEL), U4.11 (AVDD); also elsewhere on the board
+5V: C21.1, C22.1, U5.7 (VDD), U5.8 (VDD); also elsewhere on the board
AMP_ENABLE: R14.1; also elsewhere on the board
AMP_SD: R14.2, R15.1, SW3.2 (B), U5.4 (~SD_MODE); also elsewhere on the board
GND: C19.2, C20.2, C21.2, C22.2, C23.2, D2.1 (K), R15.2, R19.2, RV1.1, SW3.1 (A), SW3.4 (A), U4.2 (AVSSVCSEL), U4.3 (GND), U4.4 (GND), U4.6 (GND), U4.12 (GND), U5.3 (GND), U5.11 (GND), U5.15 (GND), U5.17 (PAD); also elsewhere on the board
I2C_SCL: R13.2, U4.10 (SCL); also elsewhere on the board
I2C_SDA: R12.2, U4.9 (SDA); also elsewhere on the board
I2S_BCLK: U5.16 (BCLK); also elsewhere on the board
I2S_DATA: U5.1 (DIN); also elsewhere on the board
I2S_LRCLK: U5.14 (LRCLK); also elsewhere on the board
LED_A: D2.2 (A), R18.2
MUTE_N: R16.2, SW3.5 (B); also elsewhere on the board
SENSOR_IRQ: R11.2, U4.7 (GPIO1); also elsewhere on the board
SENSOR_XSHUT: R10.2, U4.5 (XSHUT); also elsewhere on the board
SPK_N: J3.2, U5.10 (OUTN)
SPK_P: J3.1, U5.9 (OUTP)
STATUS_LED: R18.1; also elsewhere on the board
VOLUME_ADC: C23.1, R17.2, R19.1; also elsewhere on the board
VOLUME_RAW: R17.1, RV1.2

Notes on the sheet:
Sensor AVDD and pull-ups = 3.3 V. Driver must explicitly select 2V8 I/O mode.
XSHUT: drive low or release high-Z. Never enable RP2040 internal pull-up.
MAX98357A: GAIN floating = 9 dB; SD high selects LEFT. Duplicate audio on L/R.
Hardware MUTE grounds AMP_SD through switch and drives MUTE_N low.
Speaker is bridge-tied: neither speaker wire may connect to ground.
Optical factory process: dry reflow, no-wash, MSL3, remove liner, offset calibrate.

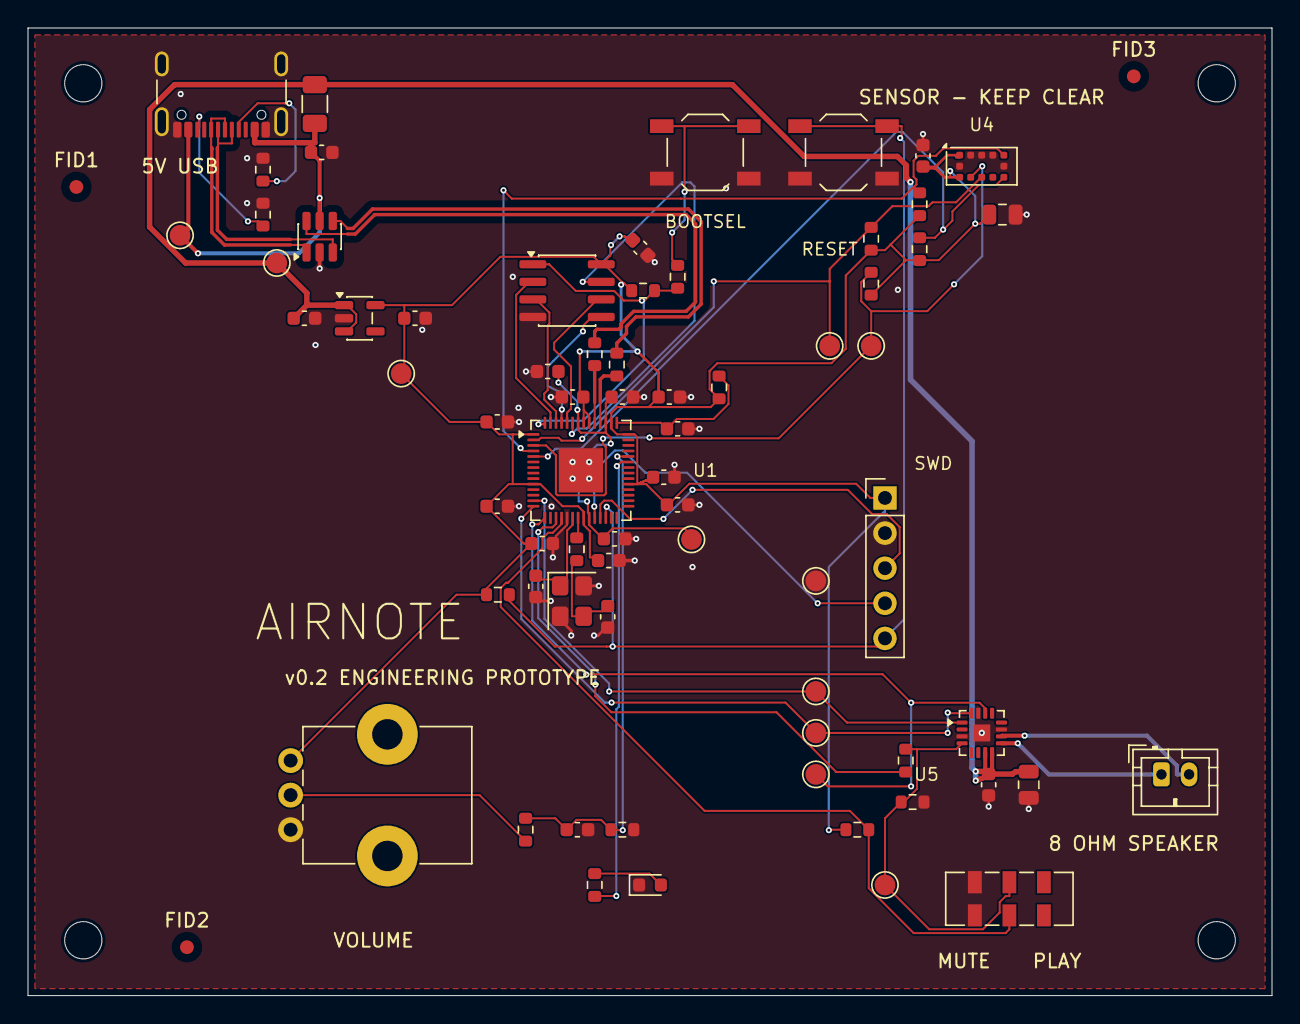
[picture p15: board airnote.kicad_pcb from above]

Board: 4 copper layers, 90.0 x 70.0 mm, 76 parts (0 on the bottom side), 43 nets.

Other parts of the board:
FID1, FID2, FID3: Fiducial; Fiducial_1mm_Mask2mm
H1, H2, H3, H4: M2.5; MountingHole_2.7mm_M2.5
