JesseLevine727/AirNote/hardware/reference/RPI-RP2040-MINIMAL_R3-S1_public/RPI-RP2040-MINIMAL_R3-S1.kicad_pcb

## KiCad design hardware/reference/RPI-RP2040-MINIMAL_R3-S1_public/RPI-RP2040-MINIMAL_R3-S1.kicad_pcb (2026-10-10)

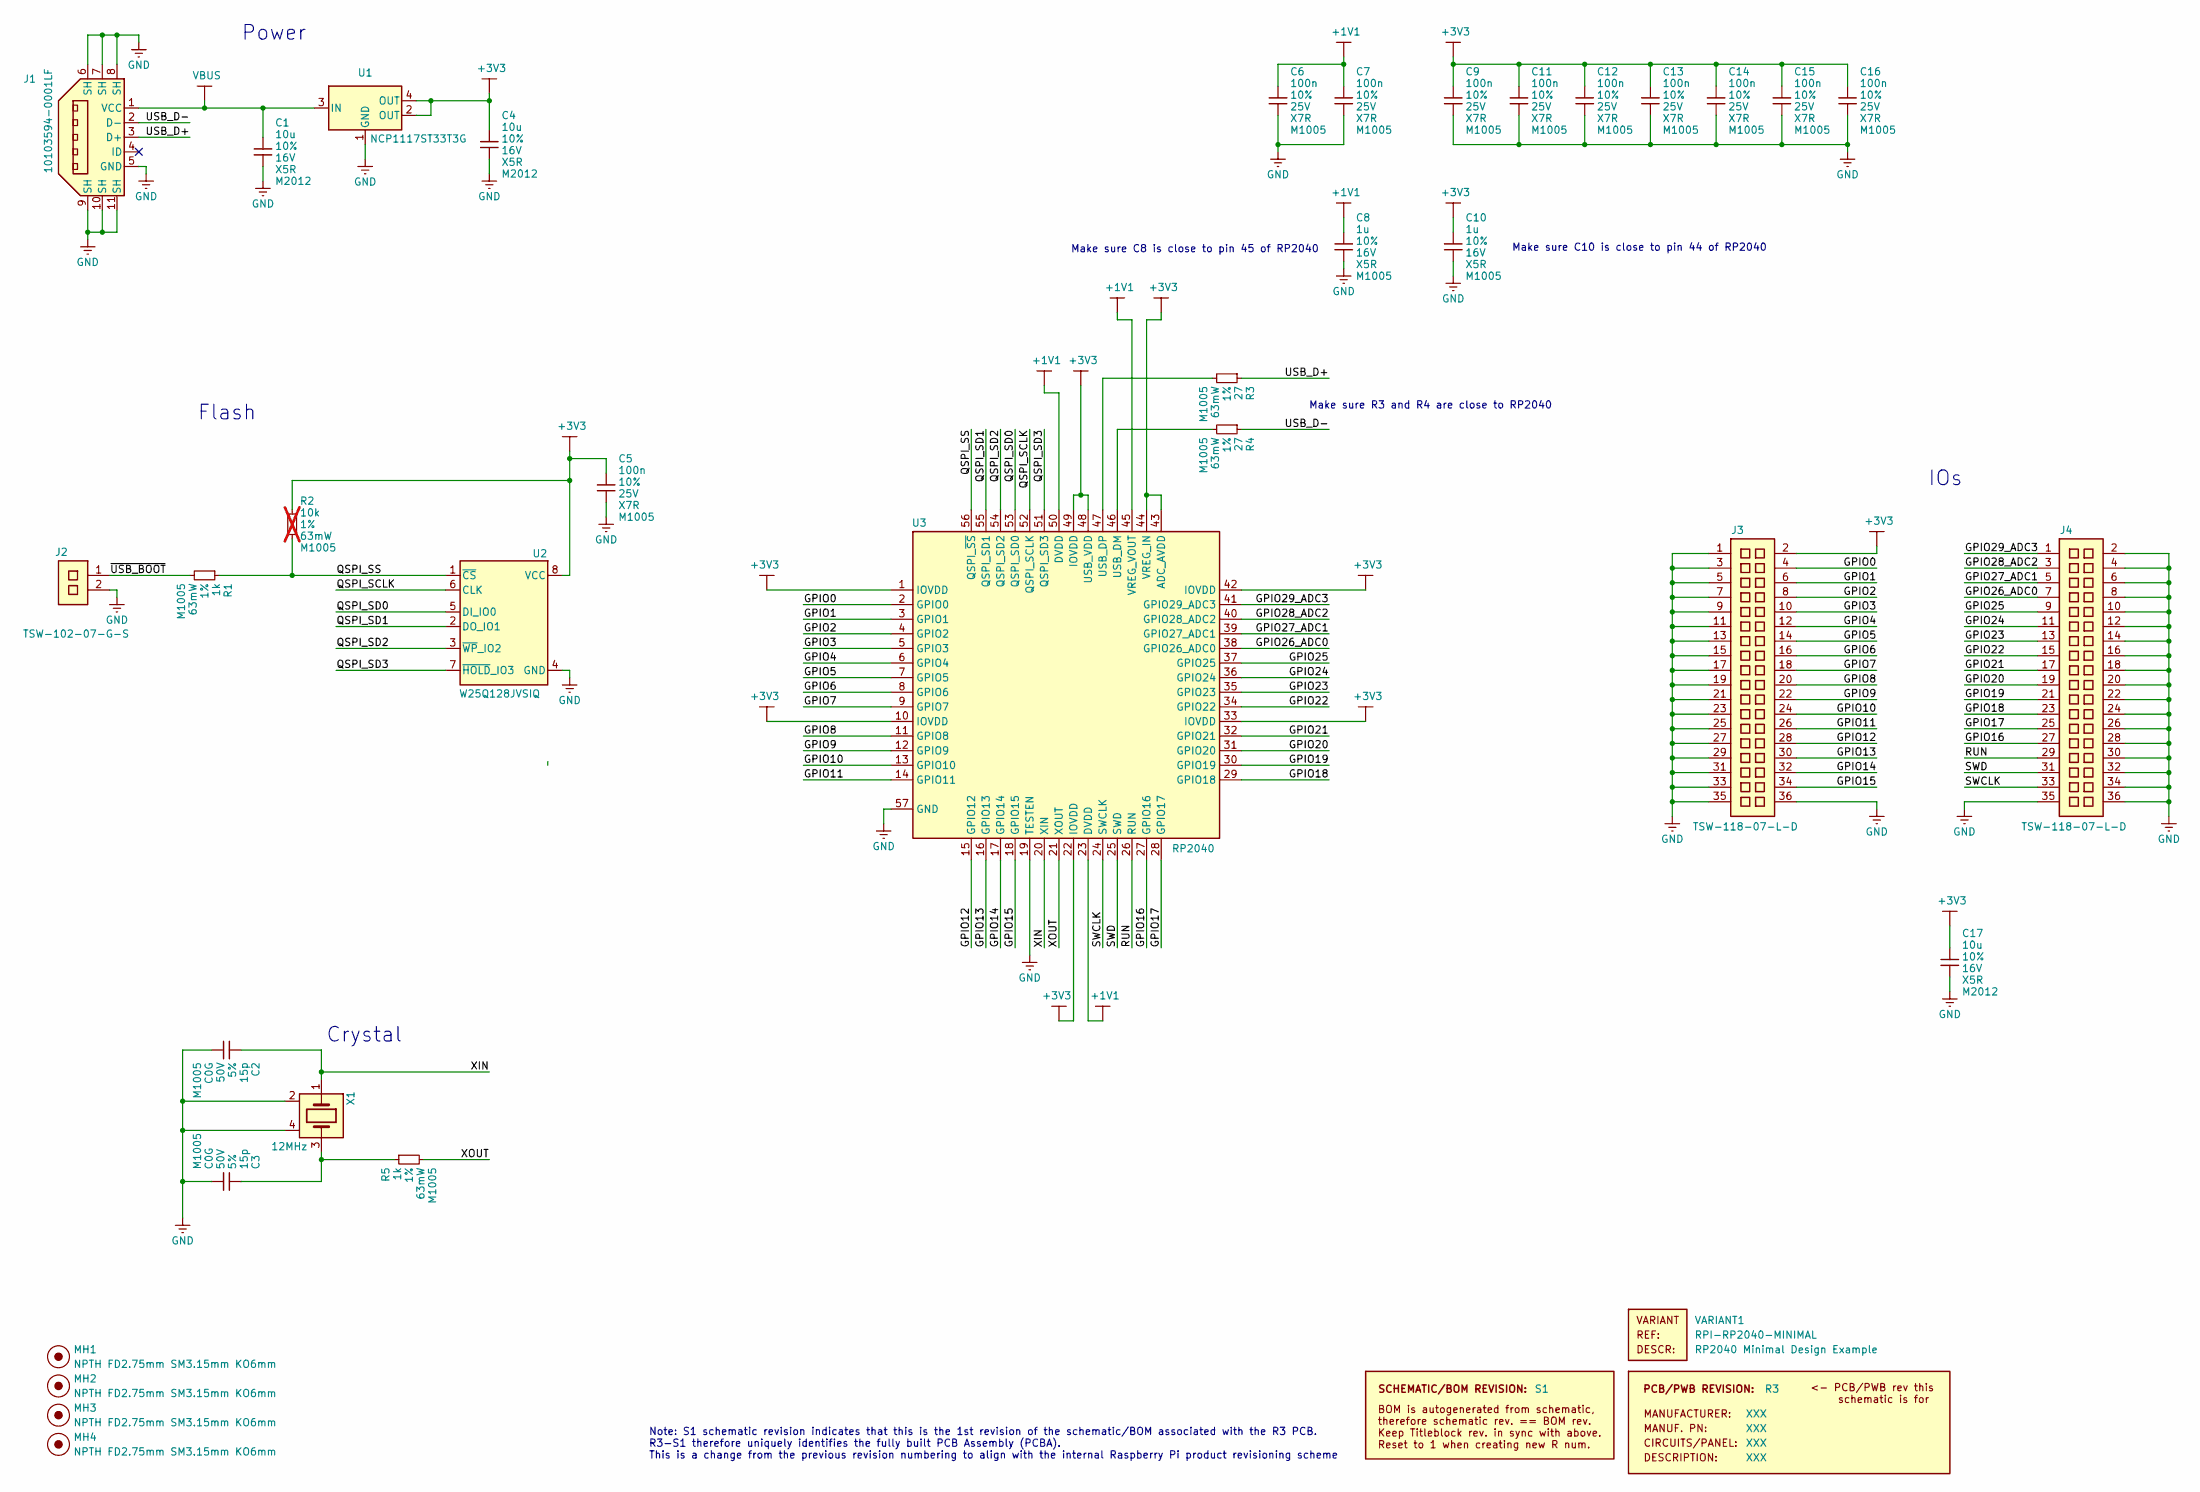
[picture p16: schematic RPI-RP2040-MINIMAL_R3-S1.kicad_sch, RP2040 Minimal Design Example]

Parts:
C1, C4, C17: 10u; generic_capc2012x125; voltage 16V; tolerance 10%; part_uid RP-01GYSK-AVBE41
C2, C3: 15p; generic_capc1005x50; voltage 50V; tolerance 5%; part_uid RP-01C89W-LLY9XV
C5, C6, C7, C9, C11, C12, C13, C14, C15, C16: 100n; generic_capc1005x50; voltage 25V; tolerance 10%; part_uid RP-01BJ9Y-KRGF41
C8, C10: 1u; generic_capc1005x50; voltage 16V; tolerance 10%; part_uid RP-01GYSK-L7FEKV
J1: 10103594-0001LF; amphenol_10103594-0001lf; part_uid RP-019A1P-1JAX7V
J2: TSW-102-07-G-S; samtec_tsw-102-07-g-s; part_uid RP-01JV5X-LY21H5
J3, J4: TSW-118-07-L-D; samtec_tsw-118-07-l-d; part_uid RP-01JWH2-G371Y4
MH1, MH2, MH3, MH4: NPTH FD2.75mm SM3.15mm KO6mm; none_mh_npth_fd2p75mm_sm3p15mm_ko6mm; part_uid RP-01HF5R-LCTEJS
PCB1: R3; manufacturer_pn XXX
R1, R5: 1k; generic_resc1005x35; tolerance 1%; voltage 50V; part_uid RP-019A1P-4Z6ZWY
R2: 10k; generic_resc1005x35; tolerance 1%; voltage 50V; part_uid RP-019A1P-53DHSX; not fitted
R3, R4: 27; generic_resc1005x35; tolerance 1%; voltage 50V; part_uid RP-01C89V-LTEYC4
SBREV1: S1
U1: NCP1117ST33T3G; onsemi_ncp1117st33t3g; voltage 3.3V; part_uid RP-01JWD9-7JRX6J
U2: W25Q128JVSIQ; generic_soic127p790x195-8; voltage 2.7-3.6V; part_uid RP-01JWD4-F1H4N9
U3: RP2040; rpi_rp2040_vias; part_uid RP-01EKHS-ZTKTEH
VARIANT1: RPI-RP2040-MINIMAL
X1: 12MHz; generic_xtalcc320x250x80-4; tolerance 30ppm; part_uid RP-01G8X7-GS352B

Connections:
+1V1: C6.1, C7.1, C8.1, U3.23 (DVDD), U3.45 (VREG_VOUT), U3.50 (DVDD)
+3V3: C4.1, C5.1, C9.1, C10.1, C11.1, C12.1, C13.1, C14.1, C15.1, C16.1, C17.1, J3.2, R2.1, U1.2 (OUT), U1.4 (OUT), U2.8 (VCC), U3.1 (IOVDD), U3.10 (IOVDD), U3.22 (IOVDD), U3.33 (IOVDD), U3.42 (IOVDD), U3.43 (ADC_AVDD), U3.44 (VREG_IN), U3.48 (USB_VDD), U3.49 (IOVDD)
/GPIO0: J3.4, U3.2 (GPIO0)
/GPIO1: J3.6, U3.3 (GPIO1)
/GPIO2: J3.8, U3.4 (GPIO2)
/GPIO3: J3.10, U3.5 (GPIO3)
/GPIO4: J3.12, U3.6 (GPIO4)
/GPIO5: J3.14, U3.7 (GPIO5)
/GPIO6: J3.16, U3.8 (GPIO6)
/GPIO7: J3.18, U3.9 (GPIO7)
/GPIO8: J3.20, U3.11 (GPIO8)
/GPIO9: J3.22, U3.12 (GPIO9)
/GPIO10: J3.24, U3.13 (GPIO10)
/GPIO11: J3.26, U3.14 (GPIO11)
/GPIO12: J3.28, U3.15 (GPIO12)
/GPIO13: J3.30, U3.16 (GPIO13)
/GPIO14: J3.32, U3.17 (GPIO14)
/GPIO15: J3.34, U3.18 (GPIO15)
/GPIO16: J4.27, U3.27 (GPIO16)
/GPIO17: J4.25, U3.28 (GPIO17)
/GPIO18: J4.23, U3.29 (GPIO18)
/GPIO19: J4.21, U3.30 (GPIO19)
/GPIO20: J4.19, U3.31 (GPIO20)
/GPIO21: J4.17, U3.32 (GPIO21)
/GPIO22: J4.15, U3.34 (GPIO22)
/GPIO23: J4.13, U3.35 (GPIO23)
/GPIO24: J4.11, U3.36 (GPIO24)
/GPIO25: J4.9, U3.37 (GPIO25)
/GPIO26_ADC0: J4.7, U3.38 (GPIO26_ADC0)
/GPIO27_ADC1: J4.5, U3.39 (GPIO27_ADC1)
/GPIO28_ADC2: J4.3, U3.40 (GPIO28_ADC2)
/GPIO29_ADC3: J4.1, U3.41 (GPIO29_ADC3)
/QSPI_SCLK: U2.6 (CLK), U3.52 (QSPI_SCLK)
/QSPI_SD0: U2.5 (DI_IO0), U3.53 (QSPI_SD0)
/QSPI_SD1: U2.2 (DO_IO1), U3.55 (QSPI_SD1)
/QSPI_SD2: U2.3 (~WP_IO2), U3.54 (QSPI_SD2)
/QSPI_SD3: U2.7 (~HOLD_IO3), U3.51 (QSPI_SD3)
/QSPI_SS: R1.1, R2.2, U2.1 (~CS), U3.56 (QSPI_~SS)
/RUN: J4.29, U3.26 (RUN)
/SWCLK: J4.33, U3.24 (SWCLK)
/SWD: J4.31, U3.25 (SWD)
/USB_D+: J1.3 (D+), R3.1
/USB_D-: J1.2 (D-), R4.1
/XIN: C2.1, U3.20 (XIN), X1.1
/XOUT: R5.2, U3.21 (XOUT)
/~USB_BOOT: J2.1, R1.2
GND: C1.2, C2.2, C3.2, C4.2, C5.2, C6.2, C7.2, C8.2, C9.2, C10.2, C11.2, C12.2, C13.2, C14.2, C15.2, C16.2, C17.2, J1.5 (GND), J1.6 (SH), J1.7 (SH), J1.8 (SH), J1.9 (SH), J1.10 (SH), J1.11 (SH), J2.2, J3.1, J3.3, J3.5, J3.7, J3.9, J3.11, J3.13, J3.15, J3.17, J3.19, J3.21, J3.23, J3.25, J3.27, J3.29, J3.31, J3.33, J3.35, J3.36, J4.2, J4.4, J4.6, J4.8, J4.10, J4.12, J4.14, J4.16, J4.18, J4.20, J4.22, J4.24, J4.26, J4.28, J4.30, J4.32, J4.34, J4.35, J4.36, U1.1 (GND), U2.4 (GND), U3.19 (TESTEN), U3.57 (GND), X1.2, X1.4
unnamed: C3.1, R5.1, X1.3
unnamed: R4.2, U3.46 (USB_DM)
unnamed: R3.2, U3.47 (USB_DP)
VBUS: C1.1, J1.1 (VCC), U1.3 (IN)

Notes on the sheet:
IOs
Power
Crystal
Make sure C8 is close to pin 45 of RP2040
Make sure C10 is close to pin 44 of RP2040
Note: S1 schematic revision indicates that this is the 1st revision of the schematic/BOM associated with the R3 PCB. R3-S1 therefore uniquely identifies the fully built PCB Assembly (PCBA). This is a change from the previous revision numbering to align with the internal Raspberry Pi product revisio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
Make sure R3 and R4 are close to RP2040
Flash

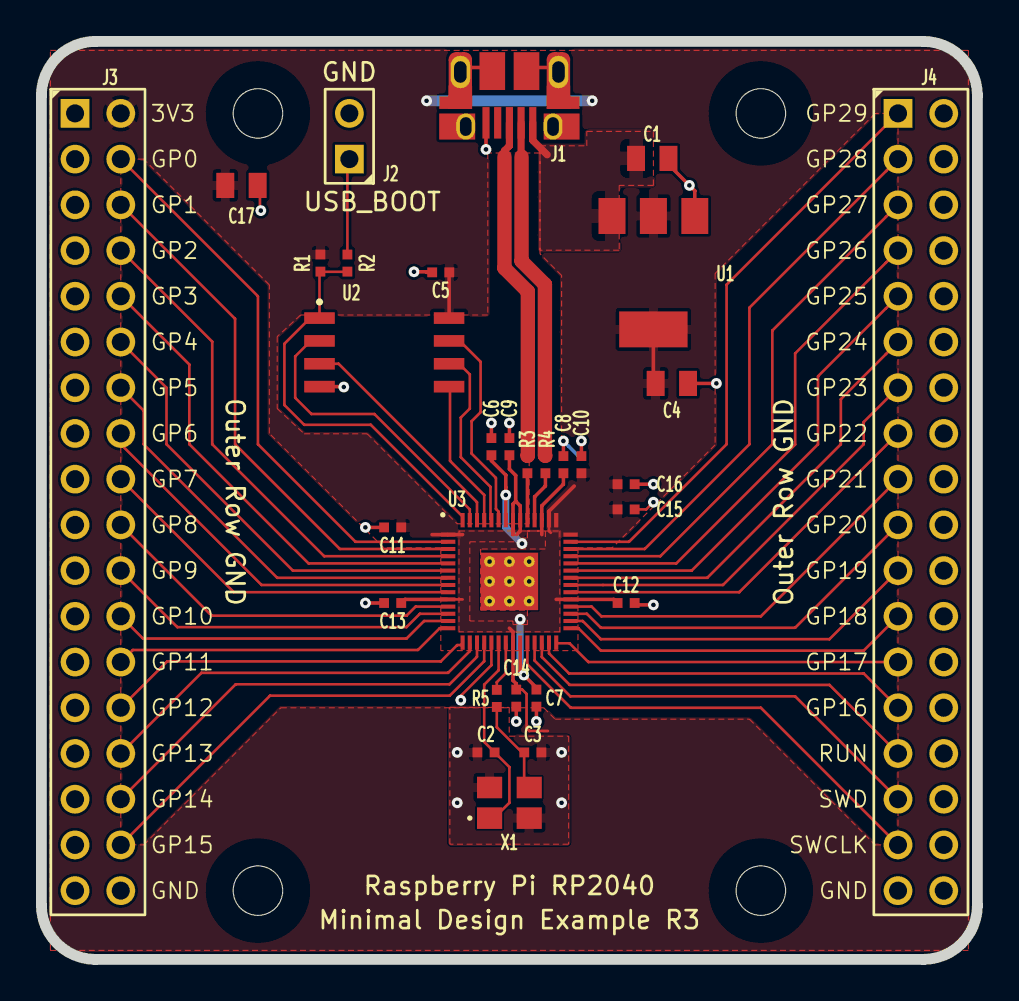
[picture p17: board RPI-RP2040-MINIMAL_R3-S1.kicad_pcb from above]

Board: 2 copper layers, 52.0 x 51.0 mm, 34 parts (0 on the bottom side), 51 nets.
