JesseLevine727/AirNote/firmware/include/boards/airnote.h

#ifndef _BOARDS_AIRNOTE_H
#define _BOARDS_AIRNOTE_H
#define AIRNOTE_BOARD
#define PICO_RP2040 1
#define PICO_DEFAULT_LED_PIN 25
#define PICO_DEFAULT_I2C 0
#define PICO_DEFAULT_I2C_SDA_PIN 0
#define PICO_DEFAULT_I2C_SCL_PIN 1
#define PICO_BOOT_STAGE2_CHOOSE_W25Q080 1
#define PICO_FLASH_SPI_CLKDIV 2
#define PICO_FLASH_SIZE_BYTES (2 * 1024 * 1024)
#define PICO_XOSC_STARTUP_DELAY_MULTIPLIER 64
#define AIRNOTE_XSHUT_PIN 2
#define AIRNOTE_SENSOR_IRQ_PIN 3
#define AIRNOTE_I2S_DATA_PIN 10
#define AIRNOTE_I2S_BCLK_PIN 11
#define AIRNOTE_I2S_LRCLK_PIN 12
#define AIRNOTE_AMP_ENABLE_PIN 14
#define AIRNOTE_MUTE_N_PIN 15
#define AIRNOTE_VOLUME_PIN 26
#endif
