JesseLevine727/AirNote/(commit log)

2026-10-10 Initial import: AirNote engineering prototype from Codex session
    Fully integrated RP2040 / VL53L1X / MAX98357A touchless instrument,
    produced by a three-agent (overseer / implementer / reviewer) Codex run on
    2026-10-10 that stopped at its usage limit after the final review.
    - KiCad 9 project: 3 schematic sheets, routed 4-layer 90x70 mm PCB
    (sha256 c35f7d92...), project libraries, exact-MPN BOM
    - Draft Gerber/drill/position exports, PDFs and render
    - Pico SDK firmware, host tests and captured UF2/ELF build
    - Independent review evidence; ERC/DRC/parity report zero issues
    Not released for fabrication: USB pair geometry/stackup, IOVDD22 bypass,
    crystal routing, USB power compliance, assemble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
    [RPI-RP2040-MINIMAL_R3-S1.kicad_pcb, RPI-RP2040-MINIMAL_R3-S1.kicad_sch, RPI-RP2040-MINIMAL_R3-S1_BOM.xlsx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]
2026-10-10 Phase 1: freeze fabricator, stackup, sourcing and USB power disposition
    - docs/fabrication_plan.md: JLCPCB Standard PCBA (VL53L1X is Standard-only),
    single-sided, JLC04161H-7628 stackup, USB pair at 0.25/0.15 mm (~90 ohm by
    JLC's calculator and an independent 2D field solve), design rules checked
    against JLC 4-layer capability, exposed-pad via options, sourcing changes
    and a rough first-order cost.
    - Found a part/footprint mismatch: W25Q16JVSSIQ is the 208-mil SOIC but the
    board uses the 150-mil footprint; switching to W25Q16JVSNIQ.
    - docs/power_budget.md: inrush charge tally (57.4 uC nominal vs 50 uC
    guideline) and suspend current, both dispositioned as accepted first-article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
2026-10-10 Phase 2: rev 0.2 layout with coupled USB pair, crystal/IOVDD fixes and JLC sourcing
    Hardware (implementer, verified by overseer):
    - Stackup set to JLC04161H-7628. USB_DIFF net class at 0.25/0.15 mm; all six
    USB nets on F.Cu with no vias over continuous In1 GND.
    - Crystal moved under U1: XIN 4.1 mm with no vias (was 7.8 mm, 2 vias).
    IOVDD pin 22 to C6 2.9 mm (was 6.1 mm).
    - airnote.kicad_dru values now carry units. KiCad had been discarding the
    unitless file, so its rules were never enforced. DRC still passes.
    - U2 corrected to W25Q16JVSNIQ (150-mil, matches footprint). J1, RV1, J2 and
    passives switched to in-stock JLC/LCSC parts. LCSC numbers in the schematic,
    footprints and bom.cs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
    [airnote-B_Cu.gbl, airnote-B_Mask.gbs, airnote-B_Paste.gbp, airnote-B_Silkscreen.gbo, airnote-Edge_Cuts.gm1, airnote-F_Cu.gtl, airnote-F_Mask.gts, airnote-F_Paste.gtp]
2026-10-10 Phase 3: independent review of rev 0.2
    Reviewer verdicts for commit 78444e8 (PCB b73600b2):
    - PASS: ERC/DRC/parity, USB geometry and USBLC6 crossover topology, rule-file
    loading, crystal network and load capacitors, stackup, fiducials, sourcing
    (all 26 MPN/LCSC pairs checked against live listings), U2/J1/J2/RV1
    footprints. RV1 PTV09A-4015F does not regress MFG-03.
    - FAIL MFG-05: GND via 0.133 mm drill-to-drill from a J1 shell slot (present
    since rev 0.1; KiCad's hole rule ignores same-net pairs).
    - FAIL MFG-11: silkscreen still v0.1, gerber job revision/finish unset,
    stale export README.
    - Physical items stay PENDING.
    New reviewer tool reviews/inspect_layout.py; all evidence regen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
2026-10-10 Phase 4: rev 0.2 review fixes and JLC order package
    Fixes for the independent review of 78444e8:
    - MFG-05: removed the GND via 0.133 mm from J1 shell slot S1. No drill web
    on the board is now below JLC's minimums (reviews/inspect_layout.py: 23/23).
    - MFG-11: silkscreen and all title blocks at rev 0.2 (gerber job Revision
    0.2); export README rewritten. Copper finish stays an order-form choice.
    - +5V after F1 widened from 0.15 to 0.4 mm, with a parallel via at U5
    (about 0.31 to 0.12 ohm to U5).
    - C15 GND via moved out of the pad. hardware/README USB figures corrected to
    the reviewer's measurements.
    Order package, generated and hashed by export_outputs.py:
    airnote-jlc-bom.csv (26 lines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
    [airnote-B_Cu.gbl, airnote-B_Mask.gbs, airnote-B_Paste.gbp, airnote-B_Silkscreen.gbo, airnote-Edge_Cuts.gm1, airnote-F_Cu.gtl, airnote-F_Mask.gts, airnote-F_Paste.gtp]
2026-10-10 Phase 4 review closure: rev 0.2 has no open static FAIL
    Targeted re-review of f187767 (PCB 52b4bbc0):
    - MFG-05 and MFG-11 closed. ERC/DRC/parity 0; inspect_layout.py 25/25;
    inspect_exports.py 75/75; netlist and all pad-to-net assignments unchanged.
    - New MFG-12 (JLC BOM/CPL/zip coherence) PASS, with JLC's rotation/anchor
    preview check PENDING at order time. New MFG-13 (order-number marker) PASS.
    - Overseer dispositions recorded as dispositions, not passes; the reviewer
    agrees with all of them.
    - Order-time items remain: quote and stock, finish, POFV vs tented,
    placement preview. Physical items stay PENDING.
    Overseer follow-ups: export README corrections from the review (J1 stake
    des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
2026-10-11 Record JLC placement corrections and cart contents
    JLC's placement preview needed D1/U2/U3/U5 rotated 90° clockwise, U4 rotated
    180°, and J1/J2/RV1/J3 moved onto their pads. These were applied in the JLC
    order (5 PCBs, 2 assembled, $158.63 USD before shipping), not in the
    exported CPL, so they are recorded here for any reupload.
